Daxxn/MicLightV2_PCB/Docs/Renders/MicLightV2_Editable.png

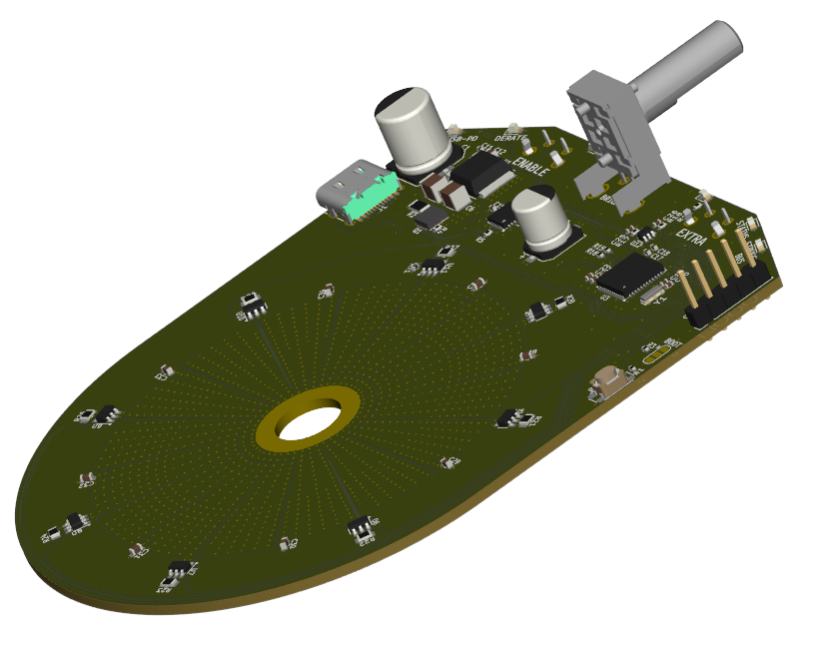
Docs/Renders/MicLightV2_Editable.png
