Daxxn/MicLightV2_PCB/Docs/BOMs/MicLightV2_REV3_BOM.csv

Reference | Value | PartNumber | Datasheet | Description | Color
C1 | 100u | 0201-0200-00001 | ${DATASHEETS}/UWT.pdf | CAP ALUM 100uF 50V 140mA@120Hz ±20% SMD,D8xL10mm Aluminum Electrolytic Capacitors - SMD ROHS
C2 | 10u | 0201-0100-00040 | ${DATASHEETS}/CL32A106KAULNNE.pdf | CAP CER 10UF 25V X5R 1210
C3 | 10u | 0201-0100-00040 | ${DATASHEETS}/CL32A106KAULNNE.pdf | CAP CER 10UF 25V X5R 1210
C4 | 10u | 0201-0100-00040 | ${DATASHEETS}/CL32A106KAULNNE.pdf | CAP CER 10UF 25V X5R 1210
C5 | 1u | 0201-0100-00051 | ${DATASHEETS}/CL10A105KA8NNNC.pdf | CAP CER 1UF 25V X5R 0603
C6 | 10u | 0201-0300-00008 | ${DATASHEETS}/TCJ.pdf | 10 µF Molded Tantalum Polymer Capacitor 35 V 1210 (3528 Metric) 200mOhm @ 100kHz
C7 | 10u | 0201-0300-00008 | ${DATASHEETS}/TCJ.pdf | 10 µF Molded Tantalum Polymer Capacitor 35 V 1210 (3528 Metric) 200mOhm @ 100kHz
C8 | 100u | 0201-0200-00018 | ~ | CAP ALUM 100uF 25V 6.3x7.7 Hilitchi Kit
C9 | 1u | 0201-0100-00051 | ${DATASHEETS}/CL10A105KA8NNNC.pdf | CAP CER 1UF 25V X5R 0603
C10 | 330n |  | ~ | Unpolarized Capacitor
C11 | 330n |  | ~ | Unpolarized Capacitor
C12 | 1u | 0201-0100-00051 | ${DATASHEETS}/CL10A105KA8NNNC.pdf | CAP CER 1UF 25V X5R 0603
C13 | 100n | 0201-0100-00001 | ${DATASHEETS}/GRM155R71H104KE14J.pdf | CAP CER 100nF 0.1UF 50V X7R 0402
C14 | 100n |  | ~ | Unpolarized Capacitor
C15 | 100n | 0201-0100-00001 | ${DATASHEETS}/GRM155R71H104KE14J.pdf | CAP CER 100nF 0.1UF 50V X7R 0402
C16 | 100n | 0201-0100-00001 | ${DATASHEETS}/GRM155R71H104KE14J.pdf | CAP CER 100nF 0.1UF 50V X7R 0402
C17 | 100n | 0201-0100-00001 | ${DATASHEETS}/GRM155R71H104KE14J.pdf | CAP CER 100nF 0.1UF 50V X7R 0402
C18 | 100n | 0201-0100-00001 | ${DATASHEETS}/GRM155R71H104KE14J.pdf | CAP CER 100nF 0.1UF 50V X7R 0402
C19 | 100n | 0201-0100-00001 | ${DATASHEETS}/GRM155R71H104KE14J.pdf | CAP CER 100nF 0.1UF 50V X7R 0402
C20 | 100n | 0201-0100-00001 | ${DATASHEETS}/GRM155R71H104KE14J.pdf | CAP CER 100nF 0.1UF 50V X7R 0402
C21 | 100n | 0201-0100-00001 | ${DATASHEETS}/GRM155R71H104KE14J.pdf | CAP CER 100nF 0.1UF 50V X7R 0402
C22 | 100n | 0201-0100-00001 | ${DATASHEETS}/GRM155R71H104KE14J.pdf | CAP CER 100nF 0.1UF 50V X7R 0402
C23 | 100n | 0201-0100-00001 | ${DATASHEETS}/GRM155R71H104KE14J.pdf | CAP CER 100nF 0.1UF 50V X7R 0402
C24 | 100n | 0201-0100-00001 | ${DATASHEETS}/GRM155R71H104KE14J.pdf | CAP CER 100nF 0.1UF 50V X7R 0402
C25 | 100n | 0201-0100-00001 | ${DATASHEETS}/GRM155R71H104KE14J.pdf | CAP CER 100nF 0.1UF 50V X7R 0402
C26 | 100n | 0201-0100-00001 | ${DATASHEETS}/GRM155R71H104KE14J.pdf | CAP CER 100nF 0.1UF 50V X7R 0402
C27 | 1u | 0201-0100-00051 | ${DATASHEETS}/CL10A105KA8NNNC.pdf | CAP CER 1UF 25V X5R 0603
C28 | 1u | 0201-0100-00051 | ${DATASHEETS}/CL10A105KA8NNNC.pdf | CAP CER 1UF 25V X5R 0603
C29 | 1u | 0201-0100-00051 | ${DATASHEETS}/CL10A105KA8NNNC.pdf | CAP CER 1UF 25V X5R 0603
C30 | 1u | 0201-0100-00051 | ${DATASHEETS}/CL10A105KA8NNNC.pdf | CAP CER 1UF 25V X5R 0603
C31 | 1u | 0201-0100-00051 | ${DATASHEETS}/CL10A105KA8NNNC.pdf | CAP CER 1UF 25V X5R 0603
C32 | 1u | 0201-0100-00051 | ${DATASHEETS}/CL10A105KA8NNNC.pdf | CAP CER 1UF 25V X5R 0603
C33 | 1u | 0201-0100-00051 | ${DATASHEETS}/CL10A105KA8NNNC.pdf | CAP CER 1UF 25V X5R 0603
C34 | 1u | 0201-0100-00051 | ${DATASHEETS}/CL10A105KA8NNNC.pdf | CAP CER 1UF 25V X5R 0603
C35 | 100n | 0201-0100-00001 | ${DATASHEETS}/GRM155R71H104KE14J.pdf | CAP CER 100nF 0.1UF 50V X7R 0402
C36 | 100n | 0201-0100-00001 | ${DATASHEETS}/GRM155R71H104KE14J.pdf | CAP CER 100nF 0.1UF 50V X7R 0402
C37 | 100n | 0201-0100-00001 | ${DATASHEETS}/GRM155R71H104KE14J.pdf | CAP CER 100nF 0.1UF 50V X7R 0402
C38 | 100n | 0201-0100-00001 | ${DATASHEETS}/GRM155R71H104KE14J.pdf | CAP CER 100nF 0.1UF 50V X7R 0402
C39 | 100n | 0201-0100-00001 | ${DATASHEETS}/GRM155R71H104KE14J.pdf | CAP CER 100nF 0.1UF 50V X7R 0402
C40 | 100n | 0201-0100-00001 | ${DATASHEETS}/GRM155R71H104KE14J.pdf | CAP CER 100nF 0.1UF 50V X7R 0402
C41 | 100n | 0201-0100-00001 | ${DATASHEETS}/GRM155R71H104KE14J.pdf | CAP CER 100nF 0.1UF 50V X7R 0402
C42 | 100n | 0201-0100-00001 | ${DATASHEETS}/GRM155R71H104KE14J.pdf | CAP CER 100nF 0.1UF 50V X7R 0402
C43 | 100n | 0201-0100-00001 | ${DATASHEETS}/GRM155R71H104KE14J.pdf | CAP CER 100nF 0.1UF 50V X7R 0402
C44 | 100n | 0201-0100-00001 | ${DATASHEETS}/GRM155R71H104KE14J.pdf | CAP CER 100nF 0.1UF 50V X7R 0402
C45 | 22u | 0201-0100-00067 | ${DATASHEETS}/C3216X5R1V226M160AC.pdf | CAP CER 22UF 35V X5R 1206
C46 | 22u | 0201-0100-00067 | ${DATASHEETS}/C3216X5R1V226M160AC.pdf | CAP CER 22UF 35V X5R 1206
C47 | 22u | 0201-0100-00067 | ${DATASHEETS}/C3216X5R1V226M160AC.pdf | CAP CER 22UF 35V X5R 1206
C48 | 22u | 0201-0100-00067 | ${DATASHEETS}/C3216X5R1V226M160AC.pdf | CAP CER 22UF 35V X5R 1206
C49 | 4u7 | 0201-0100-00074 | ${DATASHEETS}/CL21A475KLCLQNC.pdf | CAP CER 4.7UF 35V X5R 0805
C50 | 1u | 0201-0100-00050 | ${DATASHEETS}/CL05A105KO5NNNC.pdf | CAP CER 1UF 16V X5R 0402
C51 | 100n | 0201-0100-00001 | ${DATASHEETS}/GRM155R71H104KE14J.pdf | CAP CER 100nF 0.1UF 50V X7R 0402
C54 | 1u | 0201-0100-00050 | ${DATASHEETS}/CL05A105KO5NNNC.pdf | CAP CER 1UF 16V X5R 0402
C55 | 100n | 0201-0100-00001 | ${DATASHEETS}/GRM155R71H104KE14J.pdf | CAP CER 100nF 0.1UF 50V X7R 0402
D1 | IN-S63AS5UW | 0902-0000-00002 | ${DATASHEETS}/SM1204UAC.pdf | Amber 605nm LED Indication - Discrete 2.1V 1204 (3210 Metric) | AMBER
D3 | LTST-S321TBKT | 0902-0000-00004 | ${DATASHEETS}/LTST-S321TBKT.pdf | Blue 470nm LED Indication - Discrete 3.3V 2-SMD, No Lead | BLUE
D4 | IN-S63AS5UW | 0902-0000-00002 | ${DATASHEETS}/SM1204UAC.pdf | Amber 605nm LED Indication - Discrete 2.1V 1204 (3210 Metric) | AMBER
D5 | SM1204SGC | 0902-0000-00005 | ${DATASHEETS}/SM1204UAC.pdf | Green 574nm LED Indication - Discrete 2.1V 1204 (3210 Metric) | GREEN
D6 | JK3030AWT-P-H40EA0000-N0000001 | 0900-0000-00021 | ${DATASHEETS}/JSeries-3030.pdf | LED J NEUTRAL WHT 4000K SMD | WHITE
D7 | JK3030AWT-P-H40EA0000-N0000001 | 0900-0000-00021 | ${DATASHEETS}/JSeries-3030.pdf | LED J NEUTRAL WHT 4000K SMD | WHITE
D8 | JK3030AWT-P-H40EA0000-N0000001 | 0900-0000-00021 | ${DATASHEETS}/JSeries-3030.pdf | LED J NEUTRAL WHT 4000K SMD | WHITE
D9 | JK3030AWT-P-H40EA0000-N0000001 | 0900-0000-00021 | ${DATASHEETS}/JSeries-3030.pdf | LED J NEUTRAL WHT 4000K SMD | WHITE
D10 | JK3030AWT-P-H40EA0000-N0000001 | 0900-0000-00021 | ${DATASHEETS}/JSeries-3030.pdf | LED J NEUTRAL WHT 4000K SMD | WHITE
D11 | JK3030AWT-P-H40EA0000-N0000001 | 0900-0000-00021 | ${DATASHEETS}/JSeries-3030.pdf | LED J NEUTRAL WHT 4000K SMD | WHITE
D12 | JK3030AWT-P-H40EA0000-N0000001 | 0900-0000-00021 | ${DATASHEETS}/JSeries-3030.pdf | LED J NEUTRAL WHT 4000K SMD | WHITE
D13 | JK3030AWT-P-H40EA0000-N0000001 | 0900-0000-00021 | ${DATASHEETS}/JSeries-3030.pdf | LED J NEUTRAL WHT 4000K SMD | WHITE
D14 | JK3030AWT-P-H40EA0000-N0000001 | 0900-0000-00021 | ${DATASHEETS}/JSeries-3030.pdf | LED J NEUTRAL WHT 4000K SMD | WHITE
D15 | JK3030AWT-P-H40EA0000-N0000001 | 0900-0000-00021 | ${DATASHEETS}/JSeries-3030.pdf | LED J NEUTRAL WHT 4000K SMD | WHITE
D16 | JK3030AWT-P-H40EA0000-N0000001 | 0900-0000-00021 | ${DATASHEETS}/JSeries-3030.pdf | LED J NEUTRAL WHT 4000K SMD | WHITE
D17 | JK3030AWT-P-H40EA0000-N0000001 | 0900-0000-00021 | ${DATASHEETS}/JSeries-3030.pdf | LED J NEUTRAL WHT 4000K SMD | WHITE
D18 | JK3030AWT-P-H40EA0000-N0000001 | 0900-0000-00021 | ${DATASHEETS}/JSeries-3030.pdf | LED J NEUTRAL WHT 4000K SMD | WHITE
D19 | JK3030AWT-P-H40EA0000-N0000001 | 0900-0000-00021 | ${DATASHEETS}/JSeries-3030.pdf | LED J NEUTRAL WHT 4000K SMD | WHITE
D20 | JK3030AWT-P-H40EA0000-N0000001 | 0900-0000-00021 | ${DATASHEETS}/JSeries-3030.pdf | LED J NEUTRAL WHT 4000K SMD | WHITE
D21 | JK3030AWT-P-H40EA0000-N0000001 | 0900-0000-00021 | ${DATASHEETS}/JSeries-3030.pdf | LED J NEUTRAL WHT 4000K SMD | WHITE
D23 | RB751V-40-AU_R1_000A1 | 0501-0000-00004 | ${DATASHEETS}/RB751V-40-AU.pdf | Diode Schottky 40 V 300mA Surface Mount SOD-323
D24 | LTST-S321TBKT | 0902-0000-00004 | ${DATASHEETS}/LTST-S321TBKT.pdf | Blue 470nm LED Indication - Discrete 3.3V 2-SMD, No Lead | BLUE
J1 | 12402012E212A | 0318-0000-00020 | ${DATASHEETS}/12402012E212A,pdf | USB-C (USB TYPE-C) USB 2.0 Receptacle Connector 24 (16+8 Dummy) Position Surface Mount, Right Angle; Through Hole
JPR1 | SWD-HDR-5 |  | ~ | SWD Header 5Pin Wo/ SWO
Q1 | STL11N3LLH6 | 1806-0000-00022 | ${DATASHEETS}/STL11N3LLH6.pdf | N-Channel 30 V 11A (Tc) 2W (Ta), 50W (Tc) Surface Mount PowerFlat (3.3x3.3)
Q2 | MJD112T4 | 1802-0000-00002 | ${DATASHEETS}/MJD112T4.pdf | TRANS NPN DARL 100V 2A DPAK
Q3 | MJD112T4 | 1802-0000-00002 | ${DATASHEETS}/MJD112T4.pdf | TRANS NPN DARL 100V 2A DPAK
Q4 | MJD112T4 | 1802-0000-00002 | ${DATASHEETS}/MJD112T4.pdf | TRANS NPN DARL 100V 2A DPAK
Q5 | MJD112T4 | 1802-0000-00002 | ${DATASHEETS}/MJD112T4.pdf | TRANS NPN DARL 100V 2A DPAK
Q6 | MJD112T4 | 1802-0000-00002 | ${DATASHEETS}/MJD112T4.pdf | TRANS NPN DARL 100V 2A DPAK
Q7 | MJD112T4 | 1802-0000-00002 | ${DATASHEETS}/MJD112T4.pdf | TRANS NPN DARL 100V 2A DPAK
Q8 | MJD112T4 | 1802-0000-00002 | ${DATASHEETS}/MJD112T4.pdf | TRANS NPN DARL 100V 2A DPAK
Q9 | MJD112T4 | 1802-0000-00002 | ${DATASHEETS}/MJD112T4.pdf | TRANS NPN DARL 100V 2A DPAK
R1 | 10K | 0204-0000-00016 | ${DATASHEETS}/RC-Series.pdf | RES 10K OHM 5% 1/16W 0402
R2 | 10m | 0204-0200-00005 | ${DATASHEETS}/CSRN.pdf | 10 mOhms ±1% 0.5W, 1/2W Chip Resistor 1206 (3216 Metric) Current Sense Thick Film
R3 | 10K | 0204-0000-00016 | ${DATASHEETS}/RC-Series.pdf | RES 10K OHM 5% 1/16W 0402
R4 | 10K | 0204-0000-00016 | ${DATASHEETS}/RC-Series.pdf | RES 10K OHM 5% 1/16W 0402
R5 | 100 | 0204-0000-00011 | ${DATASHEETS}/RC-Series.pdf | RES 100 OHM 5% 1/16W 0402
R6 | 5K1 | 0204-0000-00115 | ${DATASHEETS}/RC-Series.pdf | RES 5.1K OHM 1% 1/16W 0402
R7 | 5K1 | 0204-0000-00115 | ${DATASHEETS}/RC-Series.pdf | RES 5.1K OHM 1% 1/16W 0402
R8 | 2K7 | 0204-0000-00121 | ${DATASHEETS}/CRGCQ_SERIES.pdf | RES 2.7K OHM 1% 1/16W 0402
R9 | 10K | 0204-0000-00016 | ${DATASHEETS}/RC-Series.pdf | RES 10K OHM 5% 1/16W 0402
R10 | 1K | 0204-0000-00032 | ${DATASHEETS}/RC-Series.pdf | RES 1K OHM 5% 1/16W 0402
R11 | 1K | 0204-0000-00032 | ${DATASHEETS}/RC-Series.pdf | RES 1K OHM 5% 1/16W 0402
R13 | 1K | 0204-0000-00032 | ${DATASHEETS}/RC-Series.pdf | RES 1K OHM 5% 1/16W 0402
R17 | 100K | 0204-0000-00013 | ${DATASHEETS}/SEI-RMCF_RMCP.pdf | RES 100K OHM 1% 1/16W 0402
R18 | 100K | 0204-0000-00013 | ${DATASHEETS}/SEI-RMCF_RMCP.pdf | RES 100K OHM 1% 1/16W 0402
R19 | PTV09A-2030F-A103 | 0404-0000-00035 | ${DATASHEETS}/PTV09.pdf | POT 10K OHM 1/20W CARBON LOG
R20 | 100 |  | ~ | Resistor
R21 | 1K 0.1% | 0204-0100-00012 | ${DATASHEETS}/RT-Series.pdf | 1 kOhms ±0.1% 0.063W, 1/16W Chip Resistor 0402 (1005 Metric) Thin Film
R22 | 10K 0.1% | 0204-0100-00019 | ${DATASHEETS}/TNPW_E3.pdf | 10 kOhms ±0.1% 0.13W Chip Resistor 0402 (1005 Metric) Anti-Sulfur, Automotive AEC-Q200, Moisture Resistant Thin Film
R23 | 10K | 0204-0000-00016 | ${DATASHEETS}/RC-Series.pdf | RES 10K OHM 5% 1/16W 0402
R24 | 10 | 0204-0200-00031 | ${DATASHEETS}/CRCW-HPE3.pdf | 10 Ohms ±1% 1.5W Chip Resistor 1218 (3246 Metric) Automotive AEC-Q200, Pulse Withstanding Thick Film
R25 | 100 |  | ~ | Resistor
R26 | 1K 0.1% | 0204-0100-00012 | ${DATASHEETS}/RT-Series.pdf | 1 kOhms ±0.1% 0.063W, 1/16W Chip Resistor 0402 (1005 Metric) Thin Film
R27 | 10K 0.1% | 0204-0100-00019 | ${DATASHEETS}/TNPW_E3.pdf | 10 kOhms ±0.1% 0.13W Chip Resistor 0402 (1005 Metric) Anti-Sulfur, Automotive AEC-Q200, Moisture Resistant Thin Film
R28 | 1K | 0204-0000-00032 | ${DATASHEETS}/RC-Series.pdf | RES 1K OHM 5% 1/16W 0402
R29 | 100K | 0204-0000-00013 | ${DATASHEETS}/SEI-RMCF_RMCP.pdf | RES 100K OHM 1% 1/16W 0402
R30 | 10K | 0204-0000-00016 | ${DATASHEETS}/RC-Series.pdf | RES 10K OHM 5% 1/16W 0402
R31 | 10 | 0204-0200-00031 | ${DATASHEETS}/CRCW-HPE3.pdf | 10 Ohms ±1% 1.5W Chip Resistor 1218 (3246 Metric) Automotive AEC-Q200, Pulse Withstanding Thick Film
R32 | 100 |  | ~ | Resistor
R33 | 1K 0.1% | 0204-0100-00012 | ${DATASHEETS}/RT-Series.pdf | 1 kOhms ±0.1% 0.063W, 1/16W Chip Resistor 0402 (1005 Metric) Thin Film
R34 | 10K 0.1% | 0204-0100-00019 | ${DATASHEETS}/TNPW_E3.pdf | 10 kOhms ±0.1% 0.13W Chip Resistor 0402 (1005 Metric) Anti-Sulfur, Automotive AEC-Q200, Moisture Resistant Thin Film
R35 | 10K | 0204-0000-00016 | ${DATASHEETS}/RC-Series.pdf | RES 10K OHM 5% 1/16W 0402
R36 | 10 | 0204-0200-00031 | ${DATASHEETS}/CRCW-HPE3.pdf | 10 Ohms ±1% 1.5W Chip Resistor 1218 (3246 Metric) Automotive AEC-Q200, Pulse Withstanding Thick Film
R37 | 100 |  | ~ | Resistor
R38 | 1K 0.1% | 0204-0100-00012 | ${DATASHEETS}/RT-Series.pdf | 1 kOhms ±0.1% 0.063W, 1/16W Chip Resistor 0402 (1005 Metric) Thin Film
R39 | 10K 0.1% | 0204-0100-00019 | ${DATASHEETS}/TNPW_E3.pdf | 10 kOhms ±0.1% 0.13W Chip Resistor 0402 (1005 Metric) Anti-Sulfur, Automotive AEC-Q200, Moisture Resistant Thin Film
R40 | 10K | 0204-0000-00016 | ${DATASHEETS}/RC-Series.pdf | RES 10K OHM 5% 1/16W 0402
R41 | 10 | 0204-0200-00031 | ${DATASHEETS}/CRCW-HPE3.pdf | 10 Ohms ±1% 1.5W Chip Resistor 1218 (3246 Metric) Automotive AEC-Q200, Pulse Withstanding Thick Film
R42 | 100 |  | ~ | Resistor
R43 | 1K 0.1% | 0204-0100-00012 | ${DATASHEETS}/RT-Series.pdf | 1 kOhms ±0.1% 0.063W, 1/16W Chip Resistor 0402 (1005 Metric) Thin Film
R44 | 10K 0.1% | 0204-0100-00019 | ${DATASHEETS}/TNPW_E3.pdf | 10 kOhms ±0.1% 0.13W Chip Resistor 0402 (1005 Metric) Anti-Sulfur, Automotive AEC-Q200, Moisture Resistant Thin Film
R45 | 10K | 0204-0000-00016 | ${DATASHEETS}/RC-Series.pdf | RES 10K OHM 5% 1/16W 0402
R46 | 10 | 0204-0200-00031 | ${DATASHEETS}/CRCW-HPE3.pdf | 10 Ohms ±1% 1.5W Chip Resistor 1218 (3246 Metric) Automotive AEC-Q200, Pulse Withstanding Thick Film
R47 | 100 |  | ~ | Resistor
R48 | 1K 0.1% | 0204-0100-00012 | ${DATASHEETS}/RT-Series.pdf | 1 kOhms ±0.1% 0.063W, 1/16W Chip Resistor 0402 (1005 Metric) Thin Film
R49 | 10K 0.1% | 0204-0100-00019 | ${DATASHEETS}/TNPW_E3.pdf | 10 kOhms ±0.1% 0.13W Chip Resistor 0402 (1005 Metric) Anti-Sulfur, Automotive AEC-Q200, Moisture Resistant Thin Film
R50 | 10K | 0204-0000-00016 | ${DATASHEETS}/RC-Series.pdf | RES 10K OHM 5% 1/16W 0402
R51 | 10 | 0204-0200-00031 | ${DATASHEETS}/CRCW-HPE3.pdf | 10 Ohms ±1% 1.5W Chip Resistor 1218 (3246 Metric) Automotive AEC-Q200, Pulse Withstanding Thick Film
R52 | 100 |  | ~ | Resistor
R53 | 1K 0.1% | 0204-0100-00012 | ${DATASHEETS}/RT-Series.pdf | 1 kOhms ±0.1% 0.063W, 1/16W Chip Resistor 0402 (1005 Metric) Thin Film
R54 | 10K 0.1% | 0204-0100-00019 | ${DATASHEETS}/TNPW_E3.pdf | 10 kOhms ±0.1% 0.13W Chip Resistor 0402 (1005 Metric) Anti-Sulfur, Automotive AEC-Q200, Moisture Resistant Thin Film
R55 | 10K | 0204-0000-00016 | ${DATASHEETS}/RC-Series.pdf | RES 10K OHM 5% 1/16W 0402
R56 | 10 | 0204-0200-00031 | ${DATASHEETS}/CRCW-HPE3.pdf | 10 Ohms ±1% 1.5W Chip Resistor 1218 (3246 Metric) Automotive AEC-Q200, Pulse Withstanding Thick Film
R57 | 100 |  | ~ | Resistor
R58 | 1K 0.1% | 0204-0100-00012 | ${DATASHEETS}/RT-Series.pdf | 1 kOhms ±0.1% 0.063W, 1/16W Chip Resistor 0402 (1005 Metric) Thin Film
R59 | 10K 0.1% | 0204-0100-00019 | ${DATASHEETS}/TNPW_E3.pdf | 10 kOhms ±0.1% 0.13W Chip Resistor 0402 (1005 Metric) Anti-Sulfur, Automotive AEC-Q200, Moisture Resistant Thin Film
R60 | 10K | 0204-0000-00016 | ${DATASHEETS}/RC-Series.pdf | RES 10K OHM 5% 1/16W 0402
R61 | 10 | 0204-0200-00031 | ${DATASHEETS}/CRCW-HPE3.pdf | 10 Ohms ±1% 1.5W Chip Resistor 1218 (3246 Metric) Automotive AEC-Q200, Pulse Withstanding Thick Film
R62 | 100 | 0204-0000-00011 | ${DATASHEETS}/RC-Series.pdf | RES 100 OHM 5% 1/16W 0402
R63 | 100 | 0204-0000-00011 | ${DATASHEETS}/RC-Series.pdf | RES 100 OHM 5% 1/16W 0402
R64 | 100 | 0204-0000-00011 | ${DATASHEETS}/RC-Series.pdf | RES 100 OHM 5% 1/16W 0402
R65 | 100 | 0204-0000-00011 | ${DATASHEETS}/RC-Series.pdf | RES 100 OHM 5% 1/16W 0402
R66 | 100 | 0204-0000-00011 | ${DATASHEETS}/RC-Series.pdf | RES 100 OHM 5% 1/16W 0402
R67 | 100 | 0204-0000-00011 | ${DATASHEETS}/RC-Series.pdf | RES 100 OHM 5% 1/16W 0402
R68 | 100 | 0204-0000-00011 | ${DATASHEETS}/RC-Series.pdf | RES 100 OHM 5% 1/16W 0402
R69 | 100 | 0204-0000-00011 | ${DATASHEETS}/RC-Series.pdf | RES 100 OHM 5% 1/16W 0402
R70 | 10K | 0204-0000-00016 | ${DATASHEETS}/RC-Series.pdf | RES 10K OHM 5% 1/16W 0402
R71 | 226K | 0204-0000-00048 | ${DATASHEETS}/RC-Series.pdf | RES 226K OHM 1% 1/16W 0402
R72 | 43K2 | 0204-0000-00110 | ${DATASHEETS}/CR-Series.pdf | RES SMD 43.2K OHM 1% 1/16W 0402
R73 | 1K |  | ~ | Resistor
S1 | TL1105VF250Q | 0401-0000-00029 | ${DATASHEETS}/TL1105.pdf | SWITCH TACTILE SPST-NO 0.05A 12V
S2 | TL1105VF250Q | 0401-0000-00029 | ${DATASHEETS}/TL1105.pdf | SWITCH TACTILE SPST-NO 0.05A 12V
SW1 | TL3365AF180QG | 0401-0000-00007 | ${DATASHEETS}/TL3365.pdf | Tactile Switch SPST-NO Top Actuated Surface Mount
U1 | UA78M33CKVURG3 | 0811-0401-00020 | ${DATASHEETS}/UA78Mxx.pdf | Linear Voltage Regulator IC Positive Fixed 1 Output 500mA TO-252-3
U2 | STM32G0B1CCU6 | 0807-0200-00024 | ${DATASHEETS}\STM32G0B1CE.pdf | ARM Cortex-M0+ STM32G0 Microcontroller IC 32-Bit 64MHz 256KB (256K x 8) FLASH UFQFPN-48 (7x7)
U3 | TCPP01-M12 | 0811-0600-00013 | ${DATASHEETS}\TCPP01-M12.pdf | USB Type-C Overvoltage/Surge Protection IC Internal Switch 12-QFN (3x3)
U4 | APX321WG-7 | 0801-0400-00011 | ${DATASHEETS}/APX321.pdf | Low Voltage, Rail to Rail Opamp
U5 | APX321WG-7 | 0801-0400-00011 | ${DATASHEETS}/APX321.pdf | Low Voltage, Rail to Rail Opamp
U6 | APX321WG-7 | 0801-0400-00011 | ${DATASHEETS}/APX321.pdf | Low Voltage, Rail to Rail Opamp
U7 | APX321WG-7 | 0801-0400-00011 | ${DATASHEETS}/APX321.pdf | Low Voltage, Rail to Rail Opamp
U8 | APX321WG-7 | 0801-0400-00011 | ${DATASHEETS}/APX321.pdf | Low Voltage, Rail to Rail Opamp
U9 | APX321WG-7 | 0801-0400-00011 | ${DATASHEETS}/APX321.pdf | Low Voltage, Rail to Rail Opamp
U10 | APX321WG-7 | 0801-0400-00011 | ${DATASHEETS}/APX321.pdf | Low Voltage, Rail to Rail Opamp
U11 | APX321WG-7 | 0801-0400-00011 | ${DATASHEETS}/APX321.pdf | Low Voltage, Rail to Rail Opamp
U12 | TC7PZ17FU | 0806-0200-00010 | ${DATASHEETS}/TC7PZ17FU.pdf | Buffer, Non-Inverting 2 Element 1 Bit per Element Push-Pull Output SC-70-6
U13 | DAC8551IADGKR | 0802-0200-00003 | ${DATASHEETS}/DAC8551.pdf | 16 Bit Digital to Analog Converter 1 8-VSSOP
U14 | INA180A2IDBVT | 0801-0300-00005 | ${DATASHEETS}/INA180.pdf | Current Sense Amplifier 1 Circuit Rail-to-Rail SOT-23-5
U15 | DAC8551IADGKR | 0802-0200-00003 | ${DATASHEETS}/DAC8551.pdf | 16 Bit Digital to Analog Converter 1 8-VSSOP
Y1 | 16MHz | 1203-0000-00001 | ${DATASHEETS}/CSTNE16M0V53L000R0.pdf | 16 MHz Ceramic Resonator Built in Capacitor 15 pF ±0.2% 40 Ohms -40°C ~ 85°C Surface Mount
