Daxxn/MicLightV2_PCB/Docs/Schematics/MicLightV2_REV3.pdf

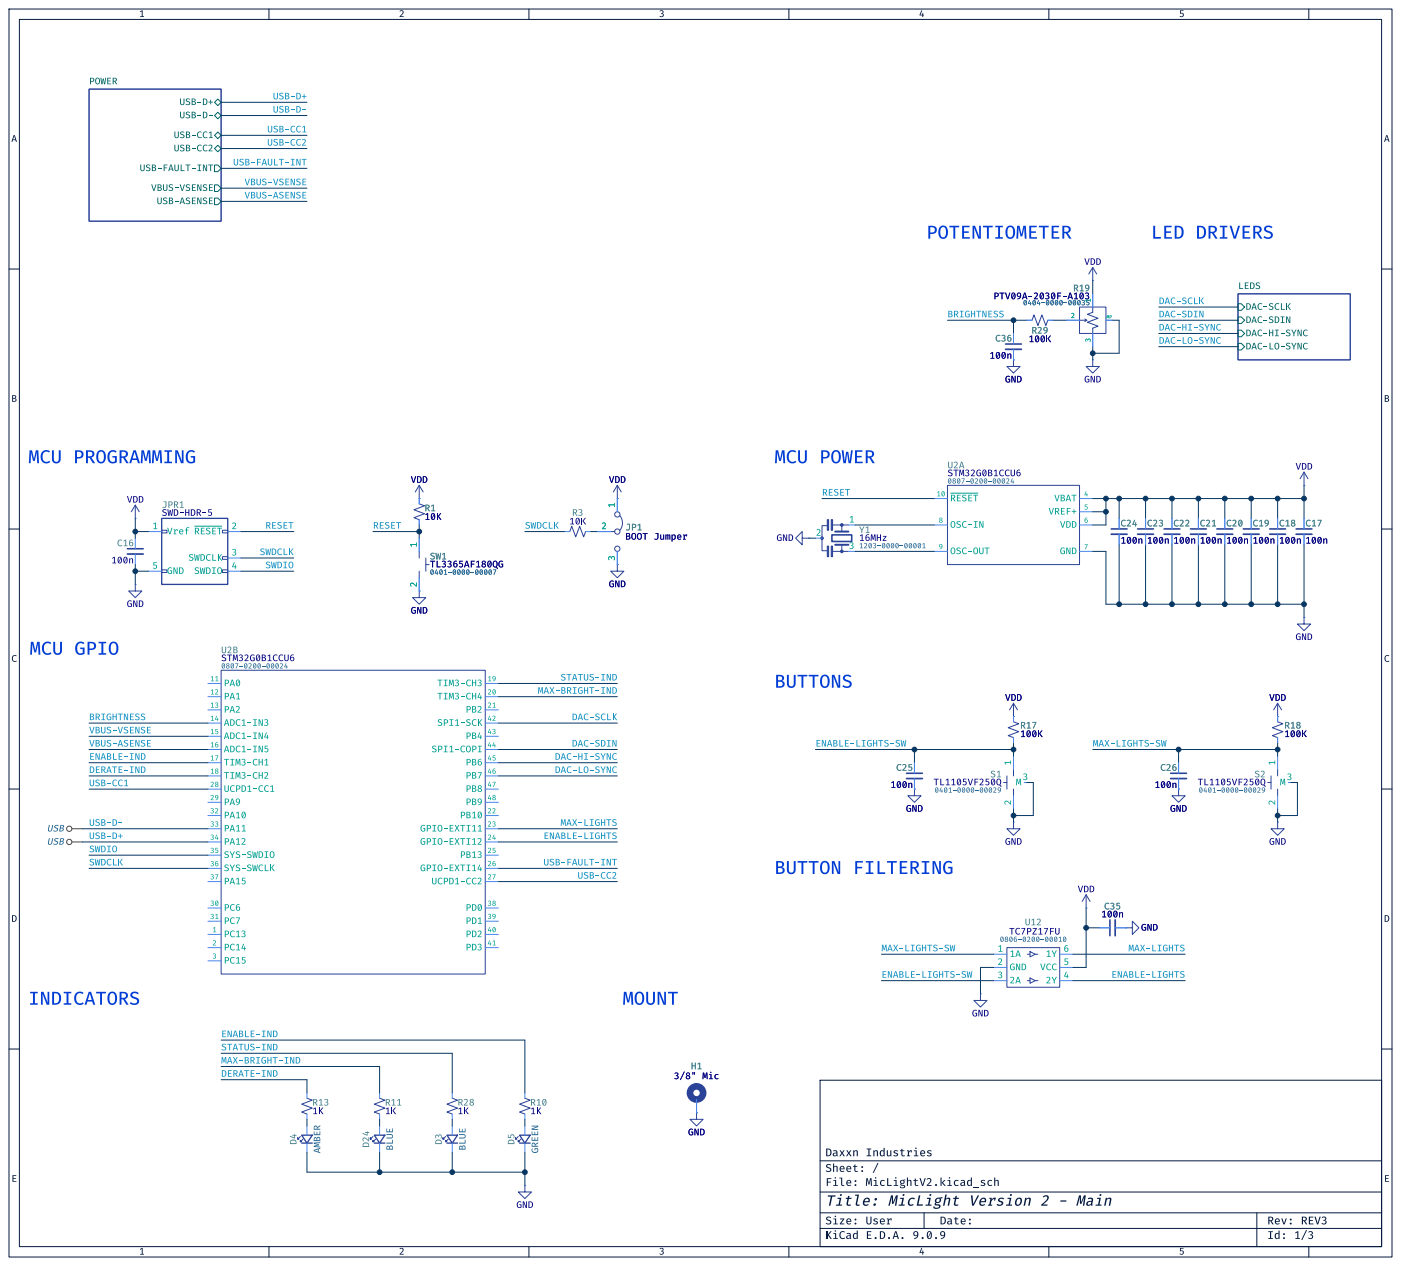
[picture p2: page 1]

LEDS USB-FAULT-INT VBUS-VSENSE USB-ASENSE USB-CC2 USB-CC1 USB-D+ USB-D- POWER

DAC-SCLK DAC-HI-SYNC
DAC-SDIN

STATUS-IND MAX-BRIGHT-IND

USB-CC1 VBUS-ASENSE USB-D- SWDCLK USB-D+ SWDIO
USB-CC2 ENABLE-IND
ENABLE-LIGHTS DERATE-IND

DAC-HI-SYNC
DAC-LO-SYNC MAX-LIGHTS

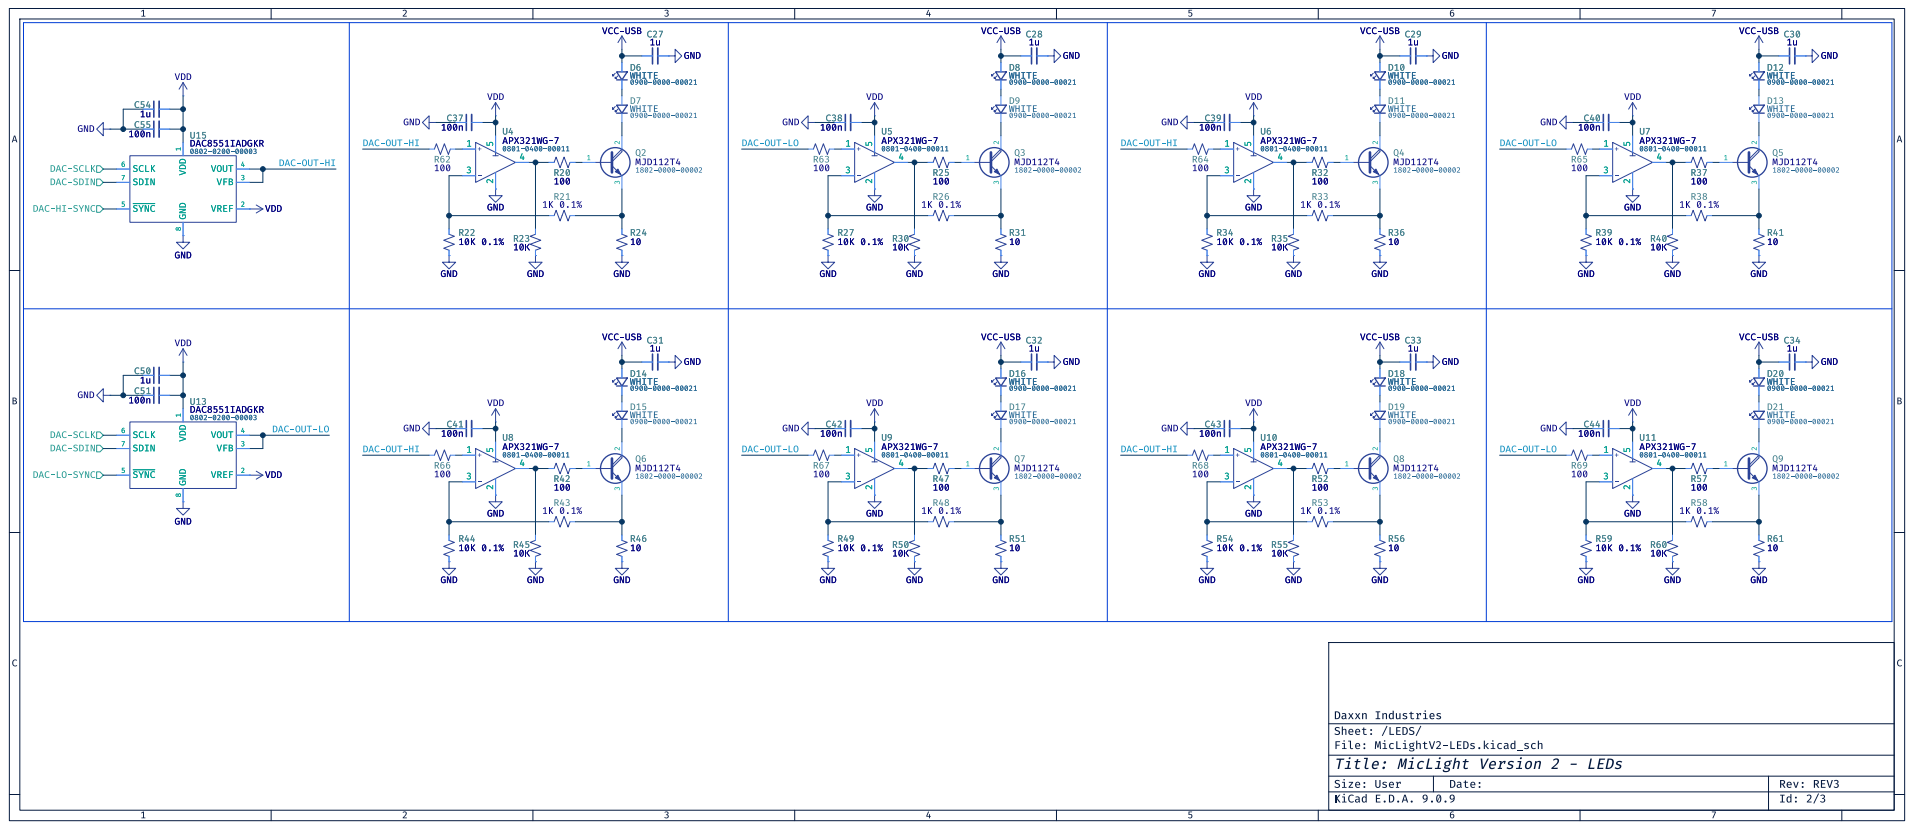
[picture p3: page 2]

1 GND
DAC-SCLK DAC-SDIN
DAC-SDIN

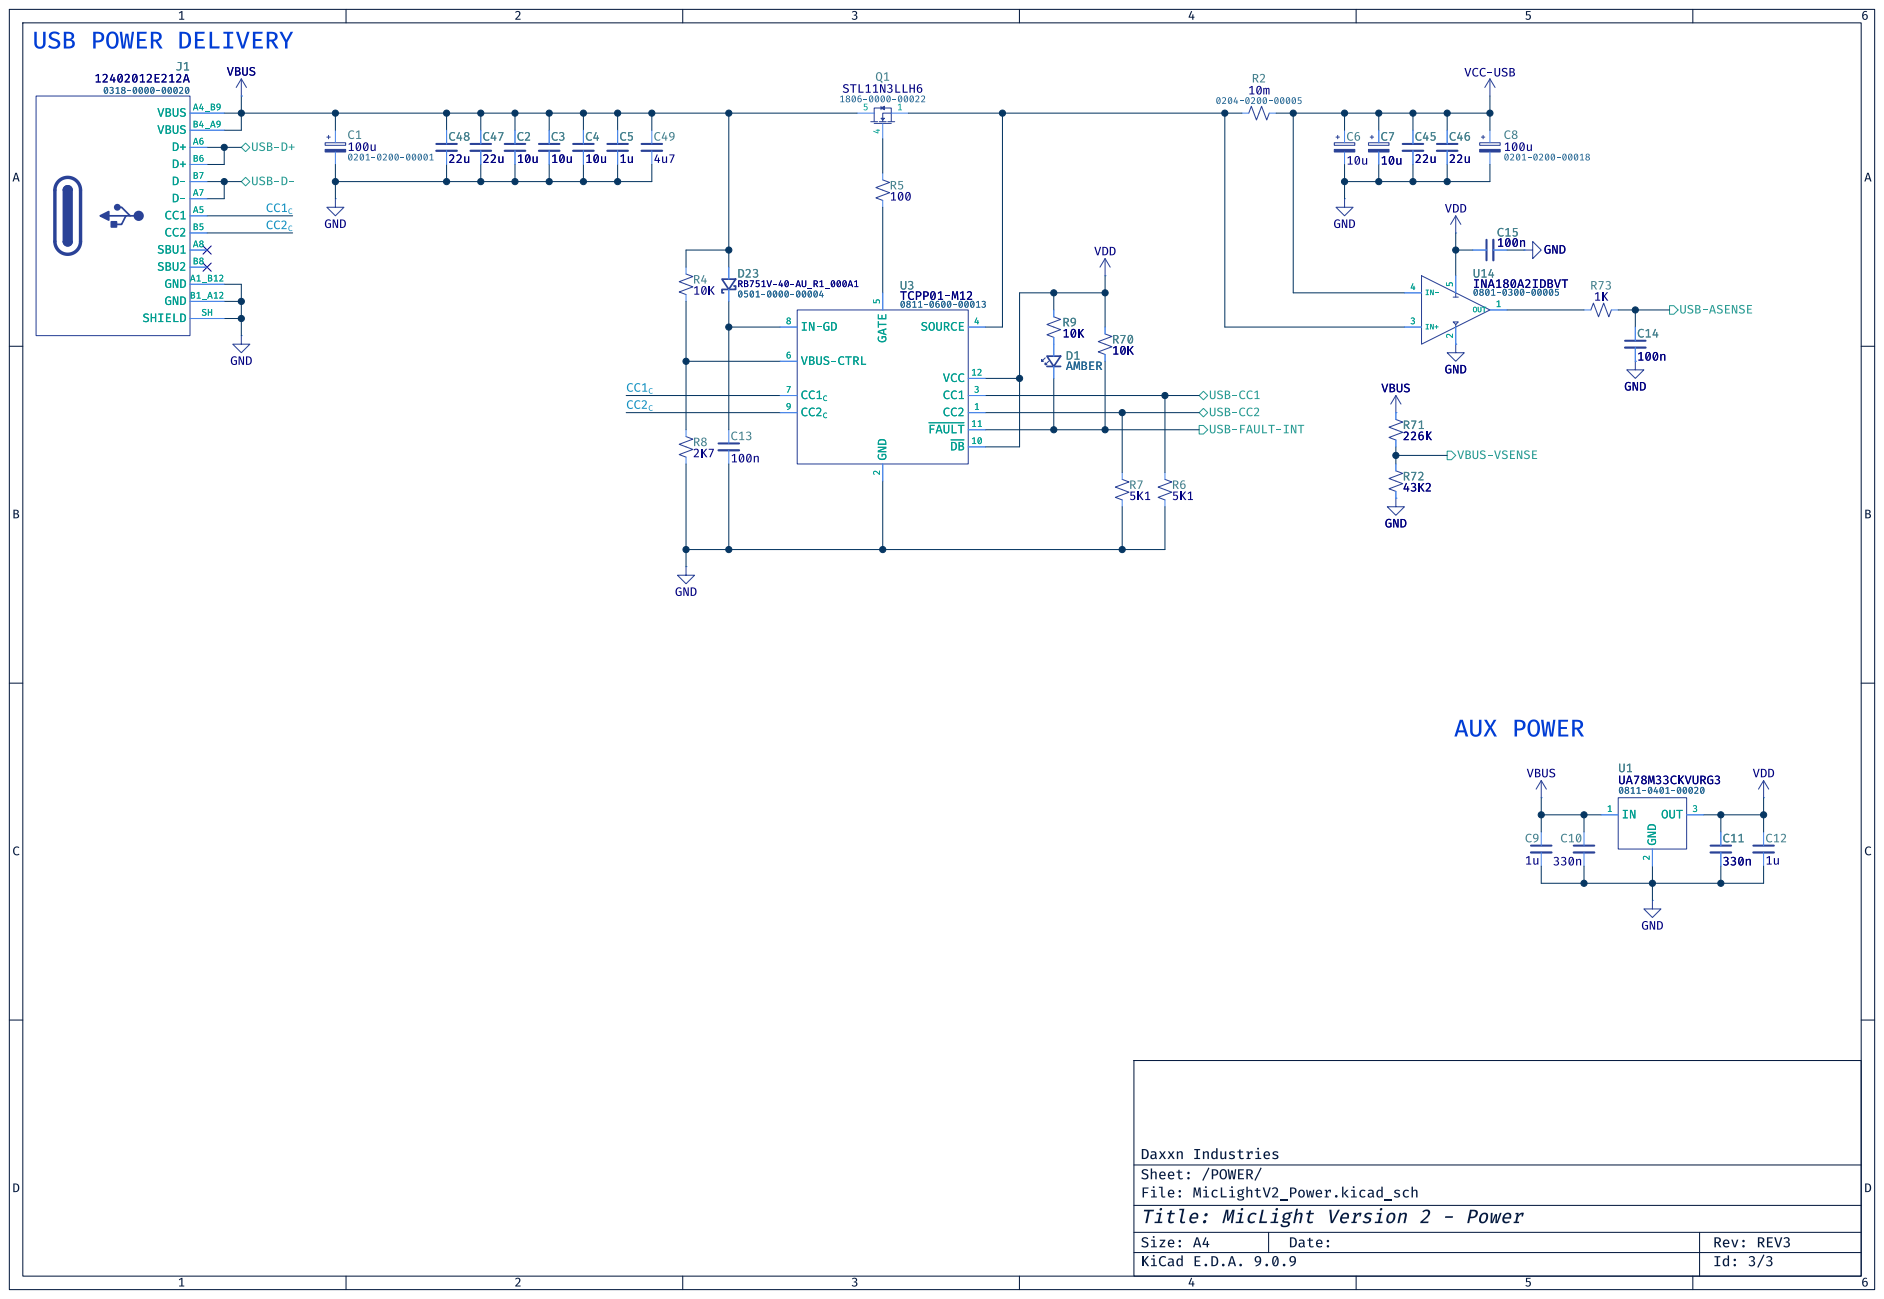
[picture p4: page 3]
