Daxxn/MicLightV2_PCB/Docs/Schematics/MicLightV2_REV2.pdf

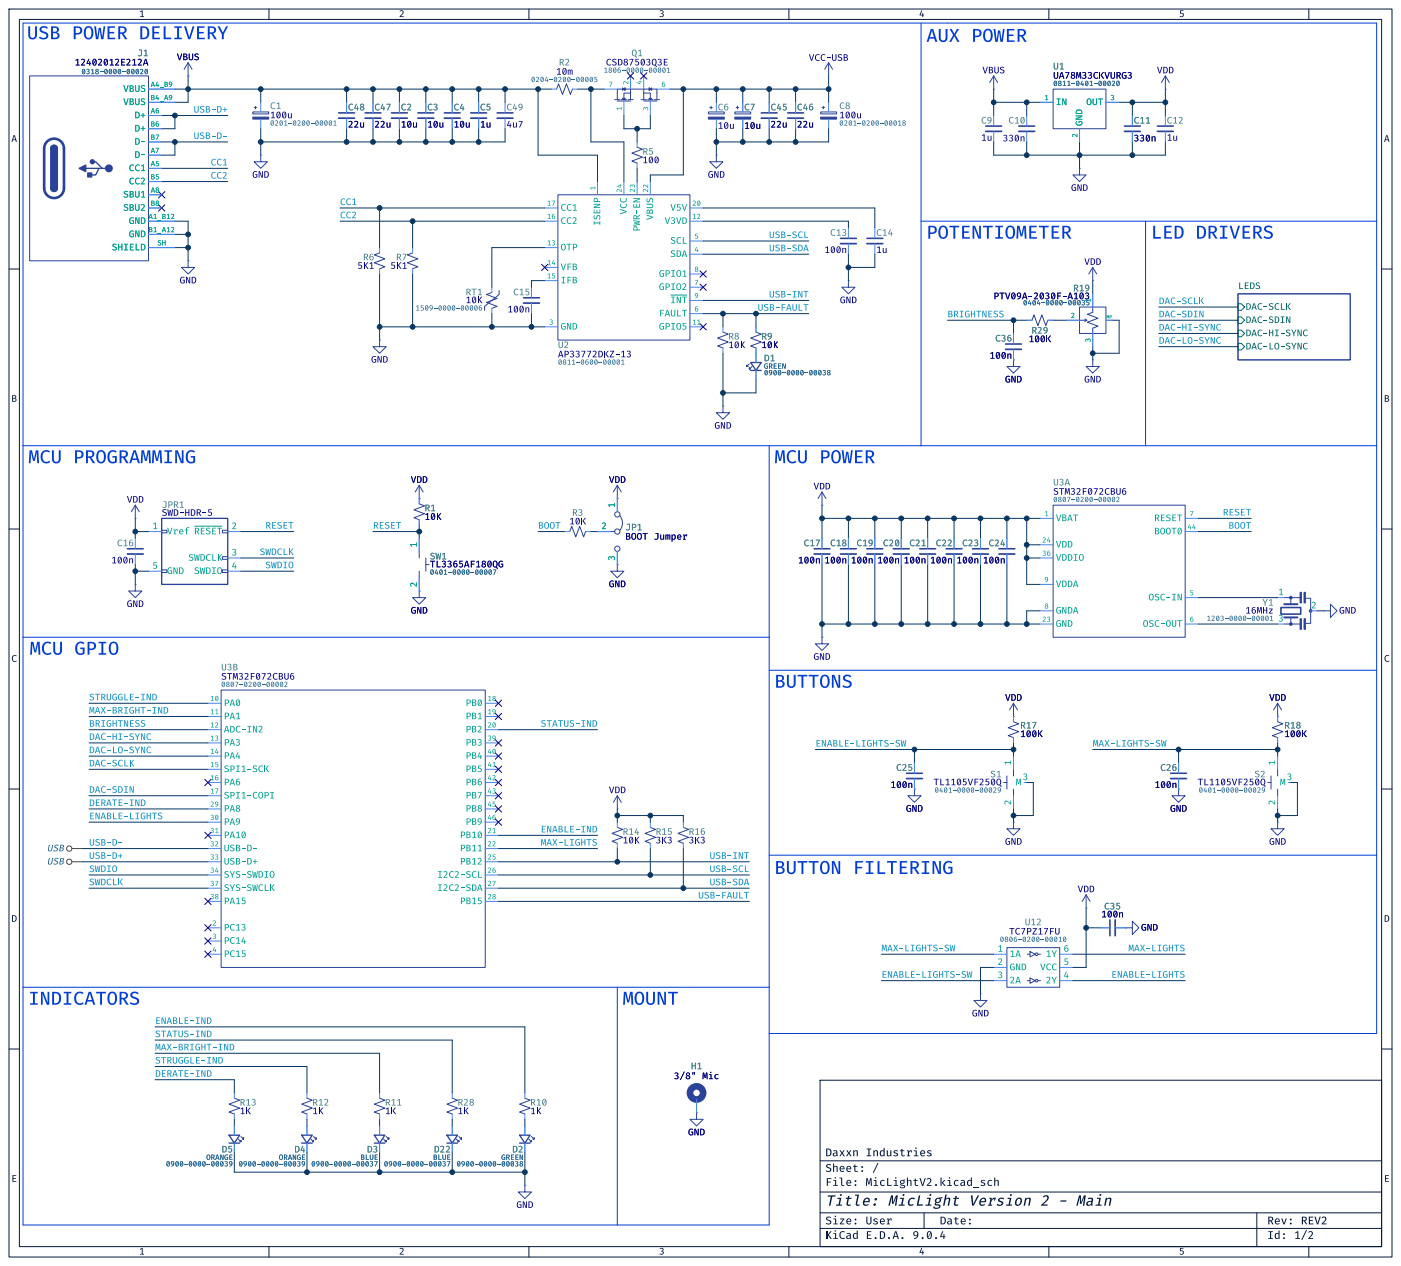
[picture p5: page 1]

USB-SCL USB-FAULT MOUNT

1 VCC 24 PWR-EN 23 VBUS 22 V5V

DAC-SCLK DAC-SDIN

DAC-SCLK DAC-HI-SYNC
DAC-SDIN

ENABLE-IND
STATUS-IND MAX-BRIGHT-IND

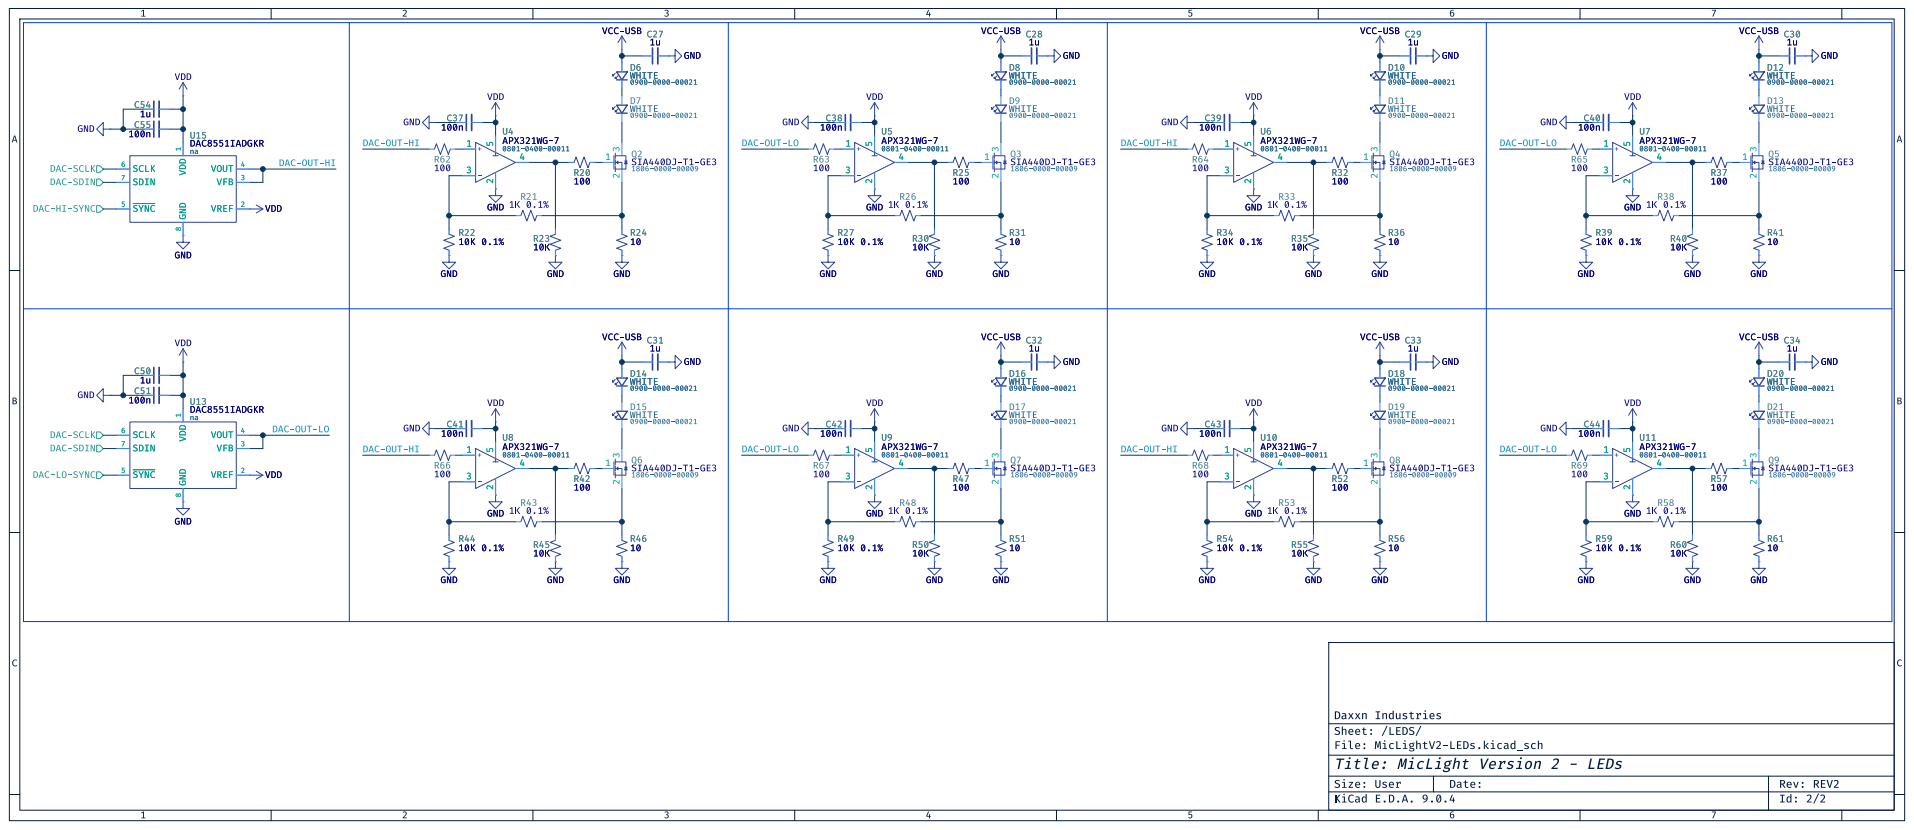
[picture p6: page 2]

DAC-SCLK DAC-SDIN

VCC-USB GND GND
