Daxxn/MicLightV2_PCB/Docs/Schematics/MicLightV2__Assembly_REV1.pdf

D14 | D12 | D¹¹ D13 D15 | D8 D6 D18 | D16 | D⁹ 1 | 2 | 3 | 4 | 5 | 6 1 | 2 | 3 | 4 | 5 | 6 ABCD | ABCD Date: KiCad E.D.A. 9.0.0 Size: A4 | Rev: 1
File: MicLightV2.kicad_pcb Sheet: Colored TOP Daxxn Industries Colored TOP - Page 1/2 D22 CZ1-0603-BLUE D22 NCR321UX U8 | C²¹ 100n | 3 R²²

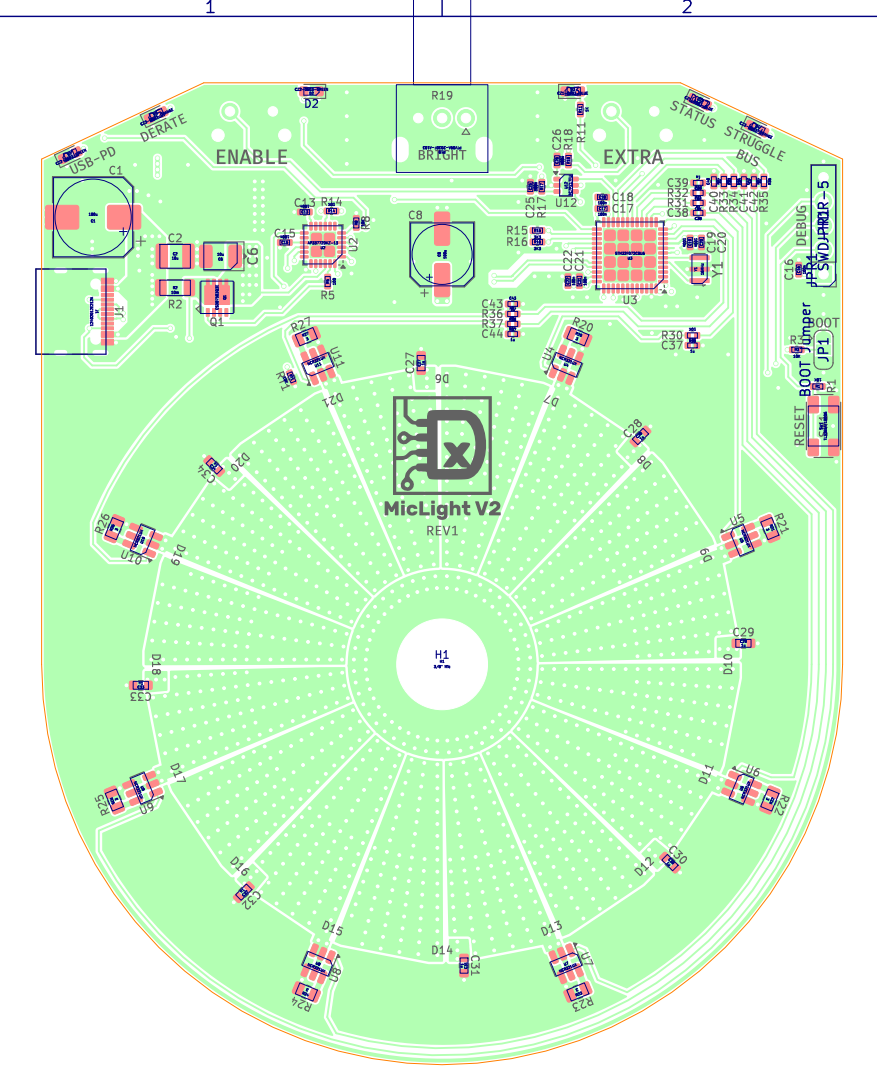
[picture p7: page 1]

Id: /1 Title: Mic Light Version 2

C46 R28 | C35 | C4 R29 | C47 S1C45 | C10 U1 | C11 C14 | C7 | C49 C⁹ C24 | R10 | C12 | R7 C48 R13 | R6 C36 | C5 C23 | R9 S2 | C3 R12 1 | 2 | 3 | 4 | 5 | 6 1 | 2 | 3 | 4 | 5 | 6 ABCD | ABCD Date: KiCad | E.D.A. 9.0.0 Size: A4 | Rev: 1
22u C45 | 330n C10 JK3030AWT-P-H40EA0000-N0000001 D7 | UA78M33CKVURG3 U1

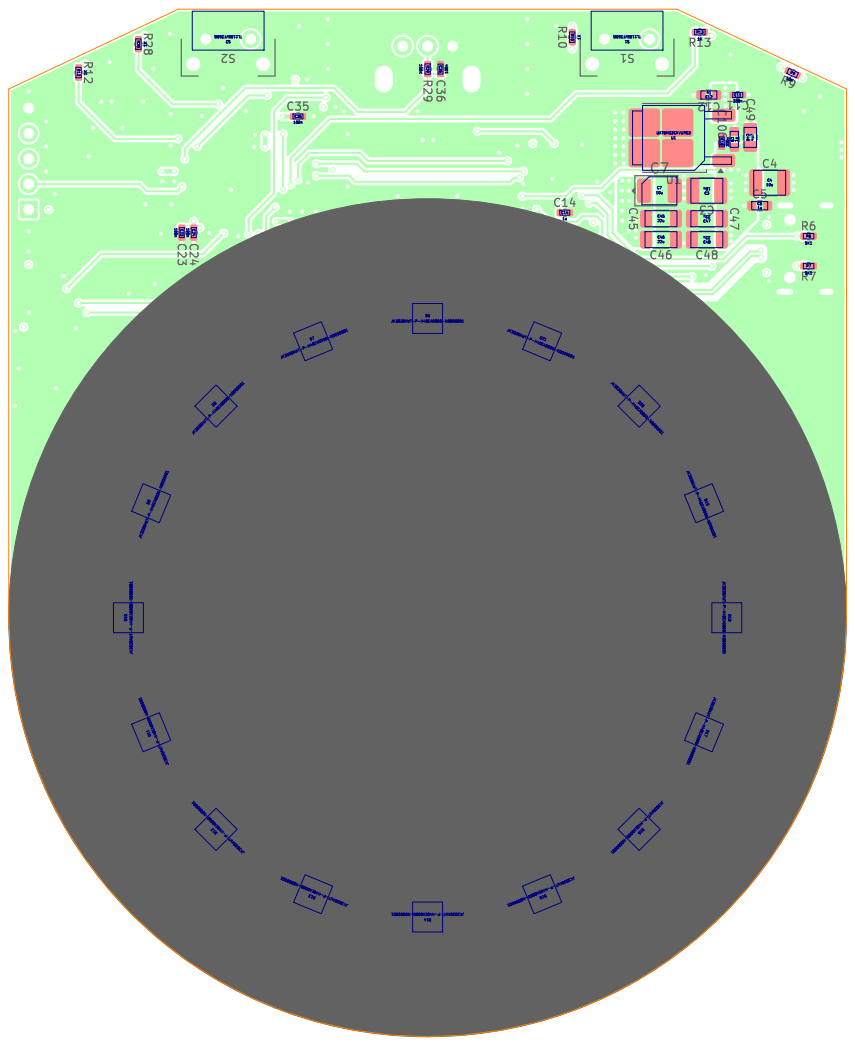
[picture p8: page 2]

Id: /1 Title: Mic Light Version 2
