Daxxn/MicLightV2_PCB/Docs/Schematics/MicLightV2_REV1.pdf

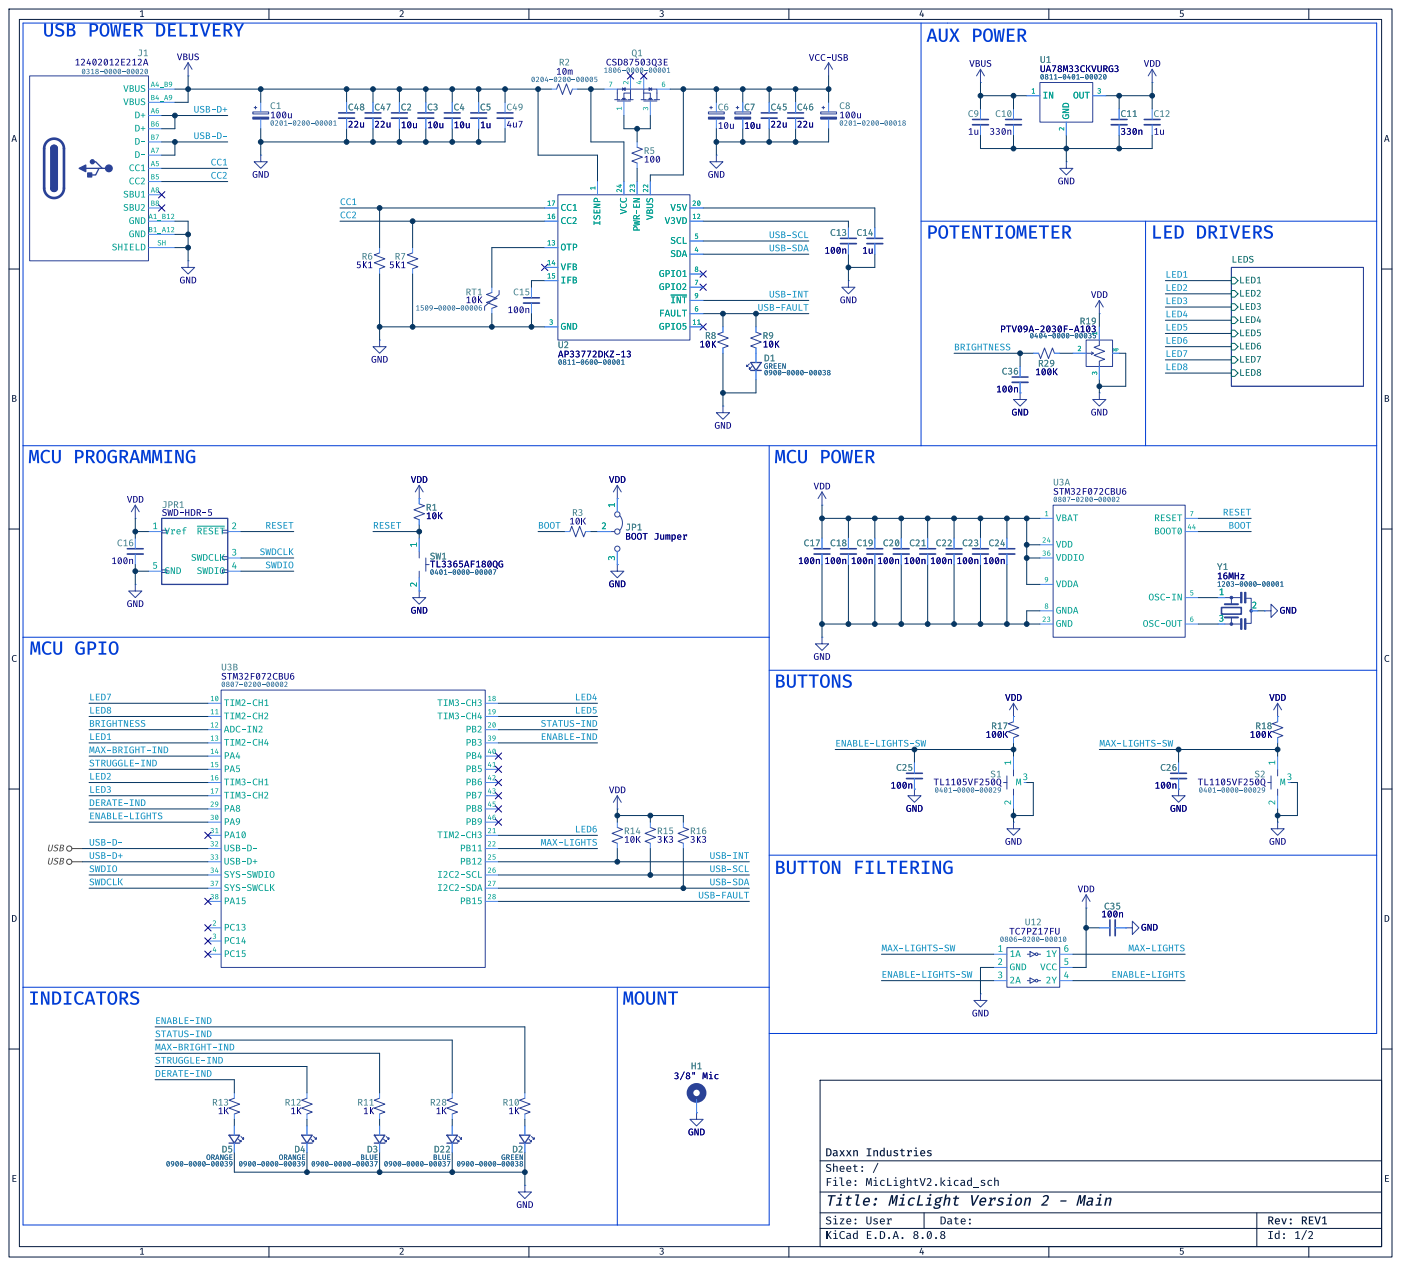
[picture p9: page 1]

20 VBUS 22 PWR-EN 23 VCC 24 GND
12 OTP

STATUS-IND MAX-LIGHTS
20 TIM2-CH3

USB-FAULT DERATE-IND

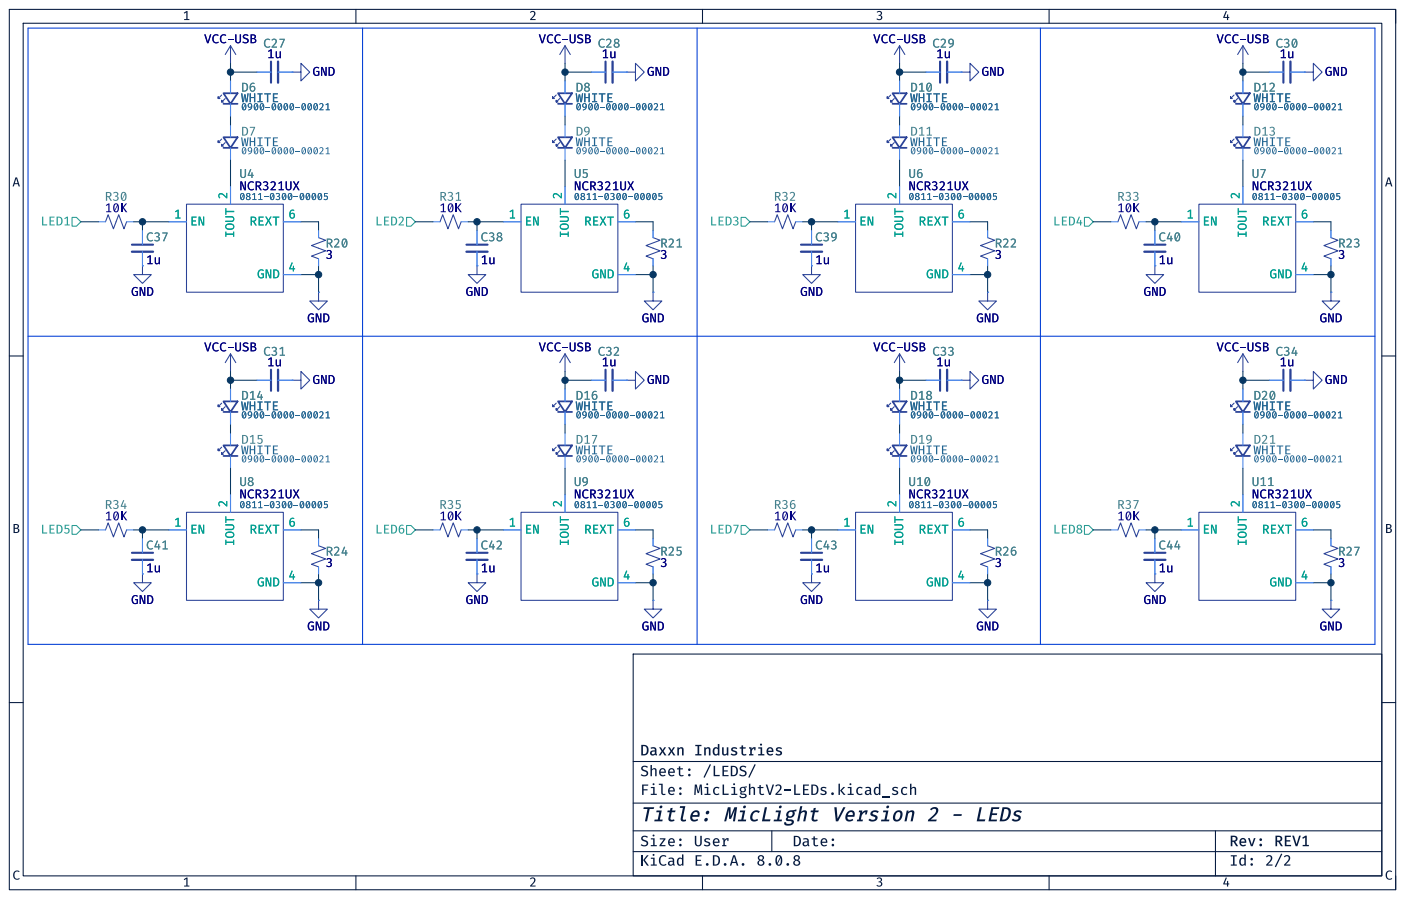
[picture p10: page 2]
