Daxxn/MicLightV2_PCB/MicLightV2.kicad_pcb

## KiCad design MicLightV2.kicad_pcb (2026-09-27)

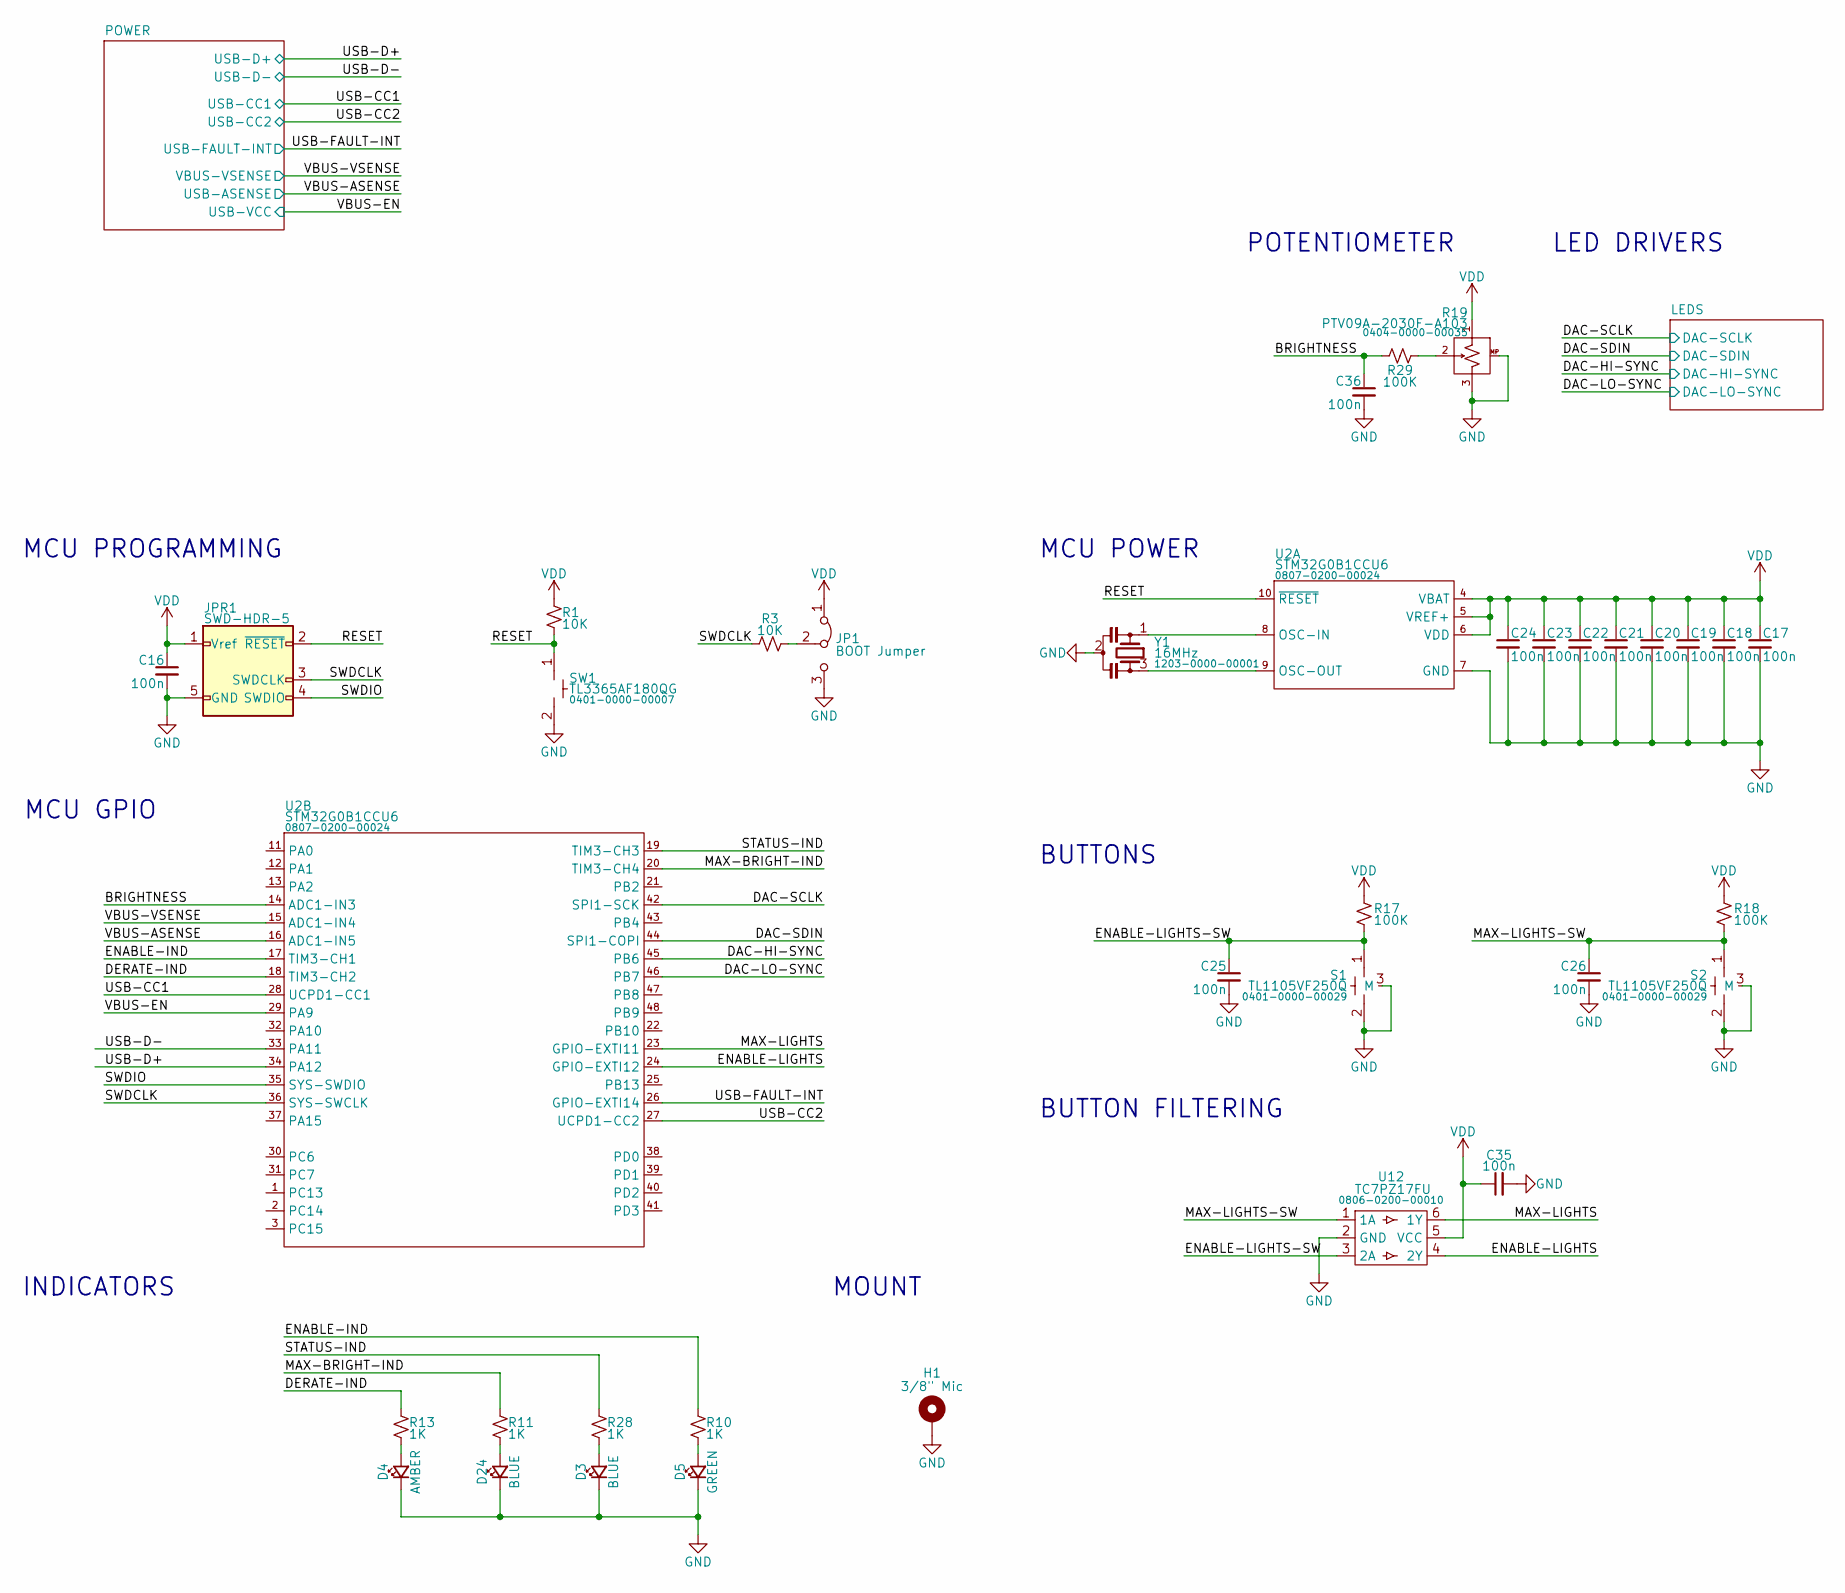
[picture p11: schematic MicLightV2.kicad_sch, MicLight Version 2 - Main]

Parts:
C16, C17, C18, C19, C20, C21, C22, C23, C24, C25, C26, C35, C36: 100n; CAP_0402; PartNumber 0201-0100-00001
D3, D24: LTST-S321TBKT; PartNumber 0902-0000-00004
D4: IN-S63AS5UW; LTST-S321TBKT; PartNumber 0902-0000-00002
D5: SM1204SGC; LTST-S321TBKT; PartNumber 0902-0000-00005
H1: 3/8" Mic; MountingHole_0.375in_Mic_Stand
JP1: BOOT Jumper; SolderJumper-3_P1.3mm_Open_RoundedPad1.0x1.5mm
JPR1: SWD-HDR-5; PinHeader_1x05_P2.54mm_Vertical
R1, R3: 10K; RES_0402; PartNumber 0204-0000-00016
R10, R11, R13, R28: 1K; RES_0402; PartNumber 0204-0000-00032
R17, R18, R29: 100K; RES_0402; PartNumber 0204-0000-00013
R19: PTV09A-2030F-A103; PartNumber 0404-0000-00035
S1, S2: TL1105VF250Q; TL1105VF; PartNumber 0401-0000-00029
SW1: TL3365AF180QG; PartNumber 0401-0000-00007
U2: STM32G0B1CCU6; QFN-48-1EP_7x7mm_P0.5mm_EP5.6x5.6mm; PartNumber 0807-0200-00024
U12: TC7PZ17FU; SOT-363_SC-70-6; PartNumber 0806-0200-00010
Y1: 16MHz; Resonator_SMD_3Pin_3.0x1.1mm; PartNumber 1203-0000-00001

Connections:
/BRIGHTNESS: C36.1, R29.1, U2.14 (PA3)
/DAC-HI-SYNC: U2.45 (PB6); also elsewhere on the board
/DAC-LO-SYNC: U2.46 (PB7); also elsewhere on the board
/DAC-SCLK: U2.42 (SPI1-SCK); also elsewhere on the board
/DAC-SDIN: U2.44 (SPI1-COPI); also elsewhere on the board
/DERATE-IND: R13.1, U2.18 (TIM3-CH2)
/ENABLE-IND: R10.1, U2.17 (TIM3-CH1)
/ENABLE-LIGHTS: U2.24 (GPIO-EXTI12), U12.4 (2Y)
/ENABLE-LIGHTS-SW: C25.1, R17.2, S1.1, U12.3 (2A)
/MAX-BRIGHT-IND: R11.1, U2.20 (TIM3-CH4)
/MAX-LIGHTS: U2.23 (GPIO-EXTI11), U12.6 (1Y)
/MAX-LIGHTS-SW: C26.1, R18.2, S2.1, U12.1 (1A)
/RESET: JPR1.2 (~RESET), R1.2, SW1.1, U2.10 (~RESET)
/STATUS-IND: R28.1, U2.19 (TIM3-CH3)
/SWDCLK: JPR1.3 (SWDCLK), R3.1, U2.36 (SYS-SWCLK)
/SWDIO: JPR1.4 (SWDIO), U2.35 (SYS-SWDIO)
/USB-CC1: U2.28 (UCPD1-CC1); also elsewhere on the board
/USB-CC2: U2.27 (UCPD1-CC2); also elsewhere on the board
/USB-D+: U2.34 (PA12); also elsewhere on the board
/USB-D-: U2.33 (PA11); also elsewhere on the board
/USB-FAULT-INT: U2.26 (GPIO-EXTI14); also elsewhere on the board
/VBUS-ASENSE: U2.16 (PA5); also elsewhere on the board
/VBUS-VSENSE: U2.15 (PA4); also elsewhere on the board
GND: C16.2, C17.2, C18.2, C19.2, C20.2, C21.2, C22.2, C23.2, C24.2, C25.2, C26.2, C35.2, C36.2, D3.1 (K), D4.1 (K), D5.1 (K), D24.1 (K), H1.1, JP1.3 (B), JPR1.5 (GND), R19.3 (B), R19.MP (Mount), S1.2, S1.3 (M), S2.2, S2.3 (M), SW1.2, U2.7 (GND), U2.49 (GND), U12.2 (GND), Y1.2; also elsewhere on the board
unnamed: D3.2 (A), R28.2
unnamed: D4.2 (A), R13.2
unnamed: D5.2 (A), R10.2
unnamed: D24.2 (A), R11.2
unnamed: JP1.2 (C), R3.2
unnamed: R19.2 (W), R29.2
unnamed: U2.8 (OSC-IN), Y1.1
unnamed: U2.9 (OSC-OUT), Y1.3
VDD: C16.1, C17.1, C18.1, C19.1, C20.1, C21.1, C22.1, C23.1, C24.1, C35.1, JP1.1 (A), JPR1.1 (Vref), R1.1, R17.1, R18.1, R19.1 (A), U2.4 (VBAT), U2.5 (VREF+), U2.6 (VDD), U12.5 (VCC); also elsewhere on the board

Notes on the sheet:
MCU GPIO
BUTTON FILTERING
INDICATORS
LED DRIVERS
POTENTIOMETER
MCU POWER
MCU PROGRAMMING
MOUNT
BUTTONS

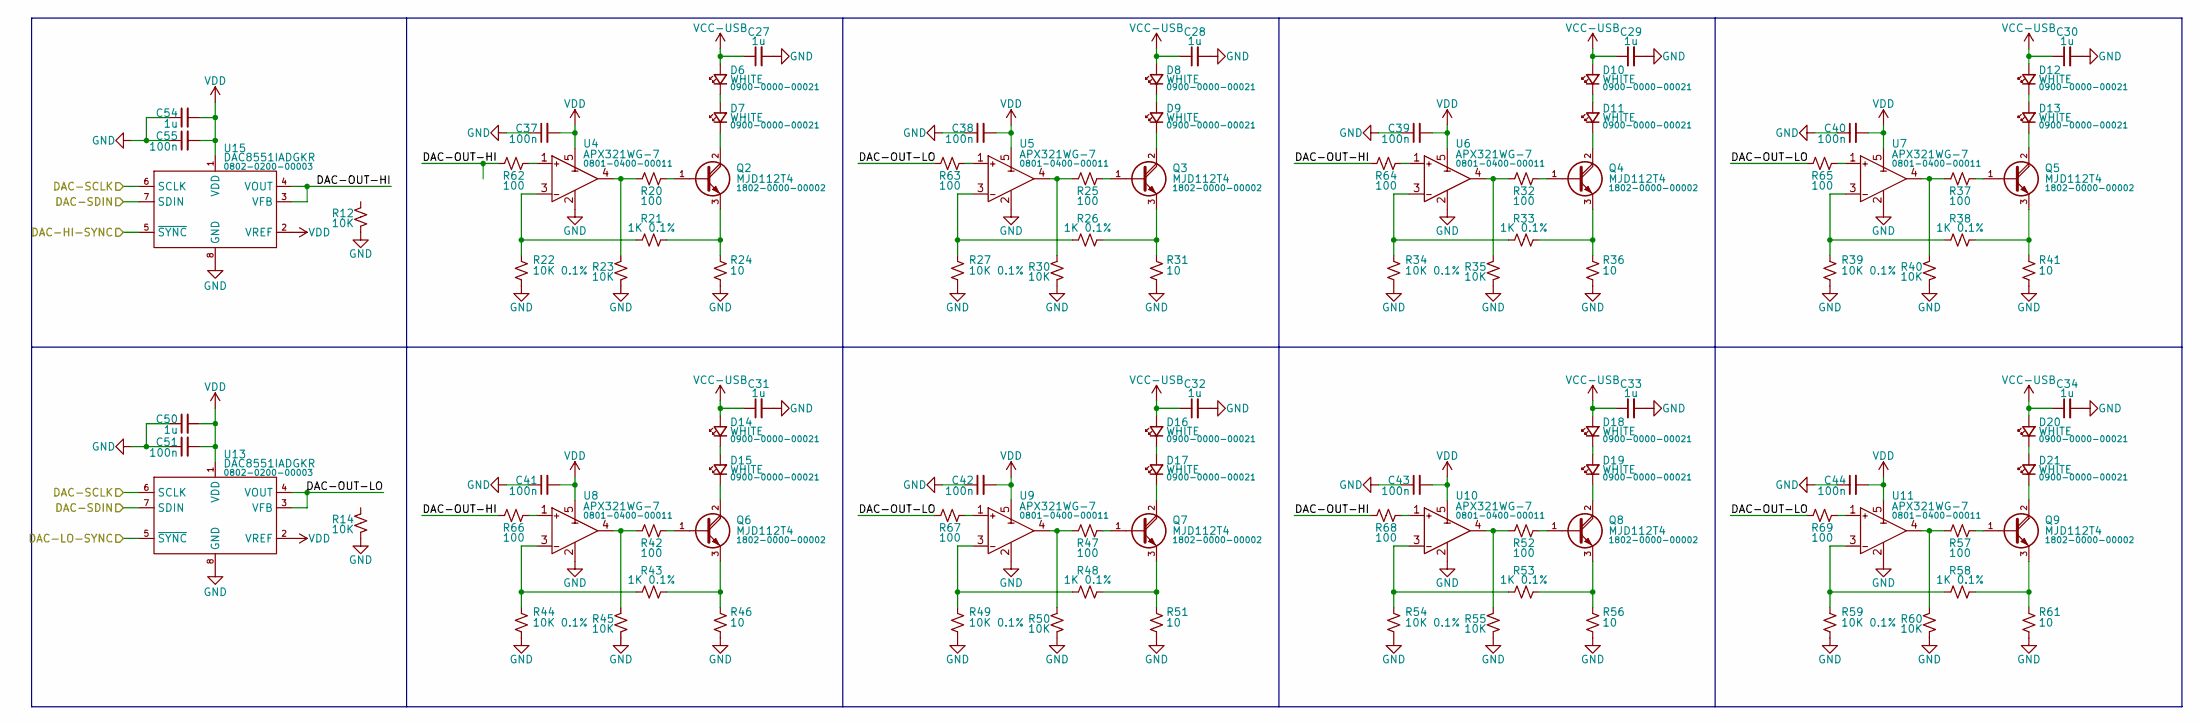
[picture p12: schematic MicLightV2-LEDs.kicad_sch, MicLight Version 2 - LEDs]

Parts:
C27, C28, C29, C30, C31, C32, C33, C34: 1u; CAP_0603; PartNumber 0201-0100-00051
C37, C38, C39, C40, C41, C42, C43, C44, C51, C55: 100n; CAP_0402; PartNumber 0201-0100-00001
C50, C54: 1u; CAP_0402; PartNumber 0201-0100-00050
D6, D7, D8, D9, D10, D11, D12, D13, D14, D15, D16, D17, D18, D19, D20, D21: JK3030AWT-P-H40EA0000-N0000001; JK3030AWT; PartNumber 0900-0000-00021
Q2, Q3, Q4, Q5, Q6, Q7, Q8, Q9: MJD112T4; TO-252-2; PartNumber 1802-0000-00002
R12, R14, R23, R30, R35, R40, R45, R50, R55, R60: 10K; RES_0402; PartNumber 0204-0000-00016
R20, R25, R32, R37, R42, R47, R52, R57: 100; RES_0402
R21, R26, R33, R38, R43, R48, R53, R58: 1K 0.1%; RES_0402; PartNumber 0204-0100-00012
R22, R27, R34, R39, R44, R49, R54, R59: 10K 0.1%; RES_0402; PartNumber 0204-0100-00019
R24, R31, R36, R41, R46, R51, R56, R61: 10; RES_1218; PartNumber 0204-0200-00031
R62, R63, R64, R65, R66, R67, R68, R69: 100; RES_0402; PartNumber 0204-0000-00011
U4, U5, U6, U7, U8, U9, U10, U11: APX321WG-7; SOT-23-5; PartNumber 0801-0400-00011
U13, U15: DAC8551IADGKR; VSSOP-8_3.0x3.0mm_P0.65mm; PartNumber 0802-0200-00003

Connections:
/DAC-HI-SYNC: U15.5 (~SYNC); also elsewhere on the board
/DAC-LO-SYNC: U13.5 (~SYNC); also elsewhere on the board
/DAC-SCLK: U13.6 (SCLK), U15.6 (SCLK); also elsewhere on the board
/DAC-SDIN: U13.7 (SDIN), U15.7 (SDIN); also elsewhere on the board
/LEDS/DAC-OUT-HI: R62.1, R64.1, R66.1, R68.1, U15.3 (VFB), U15.4 (VOUT)
/LEDS/DAC-OUT-LO: R63.1, R65.1, R67.1, R69.1, U13.3 (VFB), U13.4 (VOUT)
GND: C27.2, C28.2, C29.2, C30.2, C31.2, C32.2, C33.2, C34.2, C37.1, C38.1, C39.1, C40.1, C41.1, C42.1, C43.1, C44.1, C50.1, C51.1, C54.1, C55.1, R12.2, R14.2, R22.2, R23.2, R24.2, R27.2, R30.2, R31.2, R34.2, R35.2, R36.2, R39.2, R40.2, R41.2, R44.2, R45.2, R46.2, R49.2, R50.2, R51.2, R54.2, R55.2, R56.2, R59.2, R60.2, R61.2, U4.2 (V-), U5.2 (V-), U6.2 (V-), U7.2 (V-), U8.2 (V-), U9.2 (V-), U10.2 (V-), U11.2 (V-), U13.8 (GND), U15.8 (GND); also elsewhere on the board
unnamed: D6.1 (K), D7.2 (A)
unnamed: D7.1 (K), Q2.2 (C)
unnamed: D8.1 (K), D9.2 (A)
unnamed: D9.1 (K), Q3.2 (C)
unnamed: D10.1 (K), D11.2 (A)
unnamed: D11.1 (K), Q4.2 (C)
unnamed: D12.1 (K), D13.2 (A)
unnamed: D13.1 (K), Q5.2 (C)
unnamed: D14.1 (K), D15.2 (A)
unnamed: D15.1 (K), Q6.2 (C)
unnamed: D16.1 (K), D17.2 (A)
unnamed: D17.1 (K), Q7.2 (C)
unnamed: D18.1 (K), D19.2 (A)
unnamed: D19.1 (K), Q8.2 (C)
unnamed: D20.1 (K), D21.2 (A)
unnamed: D21.1 (K), Q9.2 (C)
unnamed: Q2.1 (B), R20.2
unnamed: Q2.3 (E), R21.2, R24.1
unnamed: Q3.1 (B), R25.2
unnamed: Q3.3 (E), R26.2, R31.1
unnamed: Q4.1 (B), R32.2
unnamed: Q4.3 (E), R33.2, R36.1
unnamed: Q5.1 (B), R37.2
unnamed: Q5.3 (E), R38.2, R41.1
unnamed: Q6.1 (B), R42.2
unnamed: Q6.3 (E), R43.2, R46.1
unnamed: Q7.1 (B), R47.2
unnamed: Q7.3 (E), R48.2, R51.1
unnamed: Q8.1 (B), R52.2
unnamed: Q8.3 (E), R53.2, R56.1
unnamed: Q9.1 (B), R57.2
unnamed: Q9.3 (E), R58.2, R61.1
unnamed: R62.2, U4.1 (IN+)
unnamed: R21.1, R22.1, U4.3 (IN-)
unnamed: R20.1, R23.1, U4.4 (OUT)
unnamed: R63.2, U5.1 (IN+)
unnamed: R26.1, R27.1, U5.3 (IN-)
unnamed: R25.1, R30.1, U5.4 (OUT)
unnamed: R64.2, U6.1 (IN+)
unnamed: R33.1, R34.1, U6.3 (IN-)
unnamed: R32.1, R35.1, U6.4 (OUT)
unnamed: R65.2, U7.1 (IN+)
unnamed: R38.1, R39.1, U7.3 (IN-)
unnamed: R37.1, R40.1, U7.4 (OUT)
unnamed: R66.2, U8.1 (IN+)
unnamed: R43.1, R44.1, U8.3 (IN-)
unnamed: R42.1, R45.1, U8.4 (OUT)
unnamed: R67.2, U9.1 (IN+)
unnamed: R48.1, R49.1, U9.3 (IN-)
unnamed: R47.1, R50.1, U9.4 (OUT)
unnamed: R68.2, U10.1 (IN+)
unnamed: R53.1, R54.1, U10.3 (IN-)
unnamed: R52.1, R55.1, U10.4 (OUT)
unnamed: R69.2, U11.1 (IN+)
unnamed: R58.1, R59.1, U11.3 (IN-)
unnamed: R57.1, R60.1, U11.4 (OUT)
VCC-USB: C27.1, C28.1, C29.1, C30.1, C31.1, C32.1, C33.1, C34.1, D6.2 (A), D8.2 (A), D10.2 (A), D12.2 (A), D14.2 (A), D16.2 (A), D18.2 (A), D20.2 (A); also elsewhere on the board
VDD: C37.2, C38.2, C39.2, C40.2, C41.2, C42.2, C43.2, C44.2, C50.2, C51.2, C54.2, C55.2, U4.5 (V+), U5.5 (V+), U6.5 (V+), U7.5 (V+), U8.5 (V+), U9.5 (V+), U10.5 (V+), U11.5 (V+), U13.1 (VDD), U13.2 (VREF), U15.1 (VDD), U15.2 (VREF); also elsewhere on the board

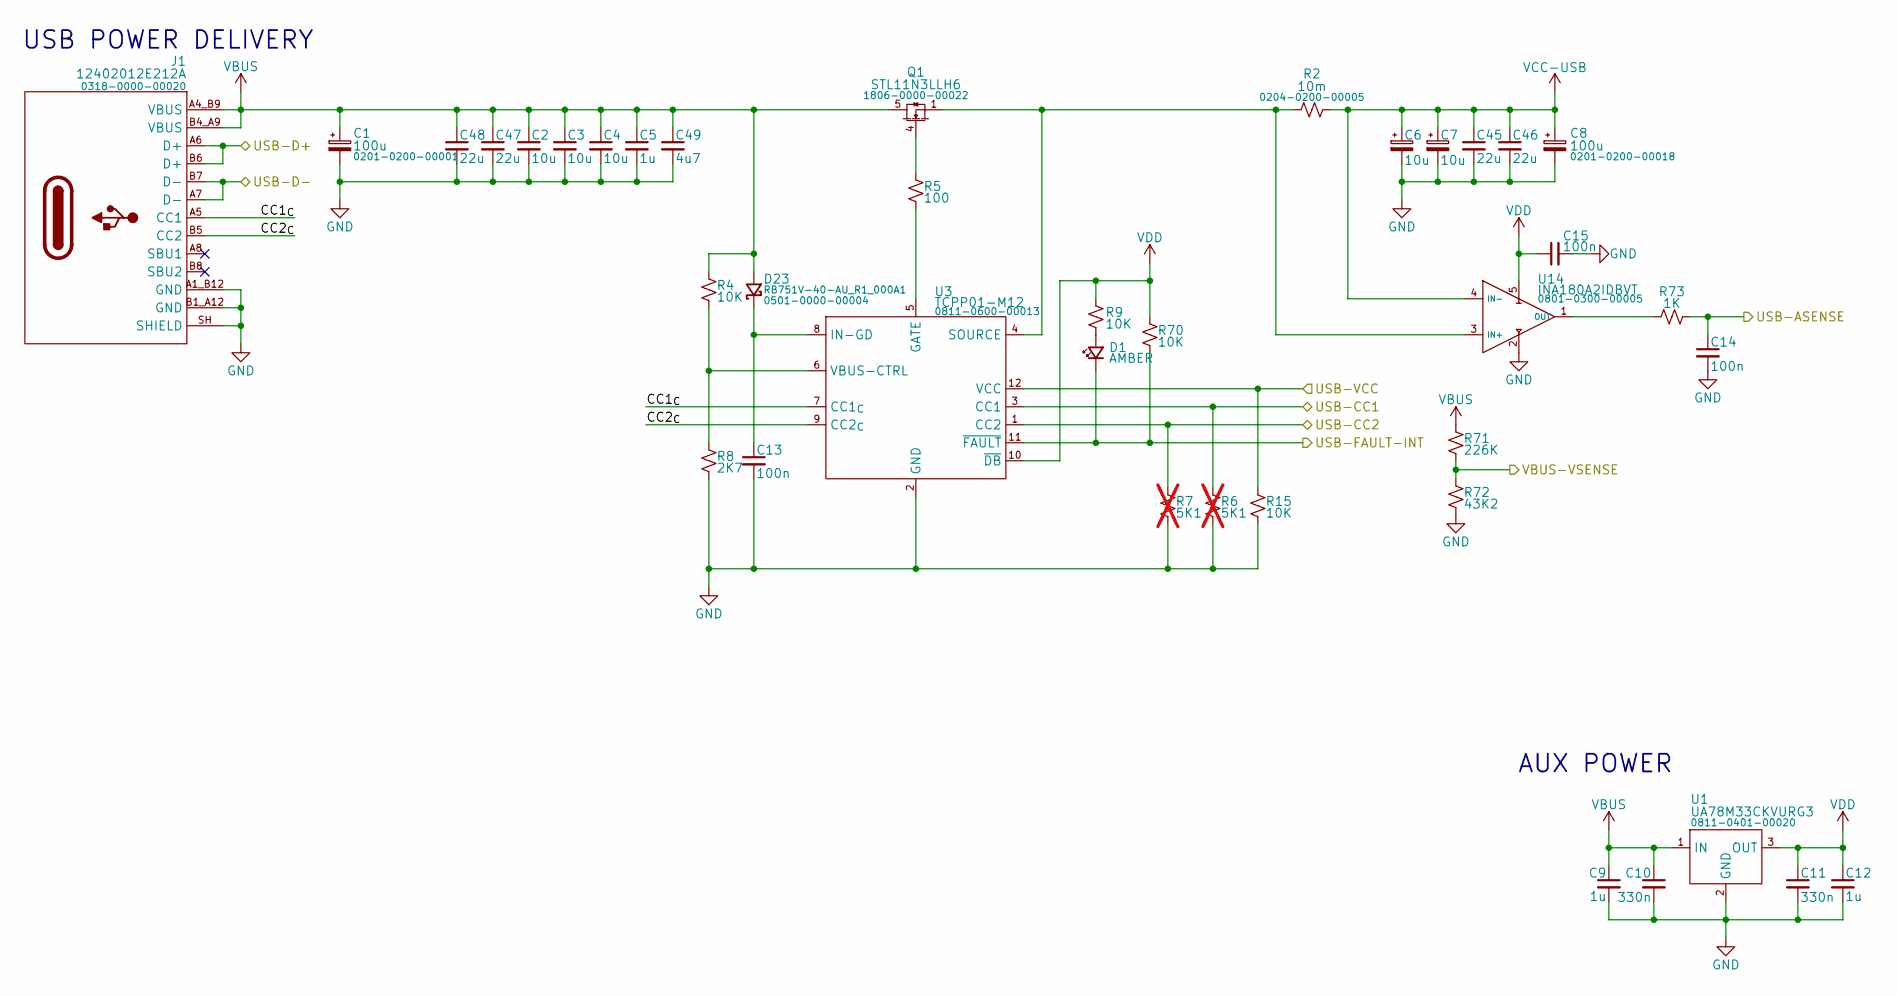
[picture p13: schematic MicLightV2_Power.kicad_sch, MicLight Version 2 - Power]

Parts:
C1: 100u; CAP_EL_8x10; PartNumber 0201-0200-00001
C2, C3, C4: 10u; CAP_1210; PartNumber 0201-0100-00040
C5, C9, C12: 1u; CAP_0603; PartNumber 0201-0100-00051
C6, C7: 10u; C-TANT-1210_EIA-3528; PartNumber 0201-0300-00008
C8: 100u; CAP_EL_6.3x7.7; PartNumber 0201-0200-00018
C10, C11: 330n; CAP_0402
C13, C15: 100n; CAP_0402; PartNumber 0201-0100-00001
C14: 100n; CAP_0402
C45, C46, C47, C48: 22u; CAP_1206; PartNumber 0201-0100-00067
C49: 4u7; CAP_0805; PartNumber 0201-0100-00074
D1: IN-S63AS5UW; LTST-S321TBKT; PartNumber 0902-0000-00002
D23: RB751V-40-AU_R1_000A1; D_SOD-323; PartNumber 0501-0000-00004
J1: 12402012E212A; PartNumber 0318-0000-00020
Q1: STL11N3LLH6; POWERFLAT_3.3MM; PartNumber 1806-0000-00022
R2: 10m; RES_1206; PartNumber 0204-0200-00005
R4, R9, R15, R70: 10K; RES_0402; PartNumber 0204-0000-00016
R5: 100; RES_0402; PartNumber 0204-0000-00011
R6, R7: 5K1; RES_0402; PartNumber 0204-0000-00115; not fitted
R8: 2K7; RES_0402; PartNumber 0204-0000-00121
R71: 226K; RES_0402; PartNumber 0204-0000-00048
R72: 43K2; RES_0402; PartNumber 0204-0000-00110
R73: 1K; RES_0402
U1: UA78M33CKVURG3; TO-252-2; PartNumber 0811-0401-00020
U3: TCPP01-M12; QFN-12-1EP_3x3mm_P0.5mm_EP1.45x1.45mm; PartNumber 0811-0600-00013
U14: INA180A2IDBVT; SOT-23-5; PartNumber 0801-0300-00005

Connections:
/POWER/CC1_{C}: J1.A5 (CC1), U3.7 (CC1_{C})
/POWER/CC2_{C}: J1.B5 (CC2), U3.9 (CC2_{C})
/USB-CC1: R6.1, U3.3 (CC1); also elsewhere on the board
/USB-CC2: R7.1, U3.1 (CC2); also elsewhere on the board
/USB-D+: J1.A6 (D+), J1.B6 (D+); also elsewhere on the board
/USB-D-: J1.A7 (D-), J1.B7 (D-); also elsewhere on the board
/USB-FAULT-INT: D1.1 (K), R70.2, U3.11 (~FAULT); also elsewhere on the board
/VBUS-ASENSE: C14.1, R73.2; also elsewhere on the board
/VBUS-VSENSE: R71.2, R72.1; also elsewhere on the board
GND: C1.2 (-), C2.2, C3.2, C4.2, C5.2, C6.2, C7.2, C8.2 (-), C9.2, C10.2, C11.2, C12.2, C13.2, C14.2, C15.2, C45.2, C46.2, C47.2, C48.2, C49.2, J1.A1_B12 (GND), J1.B1_A12 (GND), J1.SH (SHIELD), R6.2, R7.2, R8.2, R15.2, R72.2, U1.2 (GND), U3.2 (GND), U3.13 (GND), U14.2 (GND); also elsewhere on the board
unnamed: D1.2 (A), R9.2
unnamed: C13.1, D23.1 (K), U3.8 (IN-GD)
unnamed: Q1.4 (G), R5.1
unnamed: R5.2, U3.5 (GATE)
unnamed: R4.2, R8.1, U3.6 (VBUS-CTRL)
unnamed: R73.1, U14.1 (OUT)
S: Q1.1 (S), Q1.2 (S), Q1.3 (S), R2.1, U3.4 (SOURCE), U14.3 (IN+)
VBUS: C1.1 (+), C2.1, C3.1, C4.1, C5.1, C9.1, C10.1, C47.1, C48.1, C49.1, D23.2 (A), J1.A4_B9 (VBUS), J1.B4_A9 (VBUS), Q1.5 (D), R4.1, R71.1, U1.1 (IN)
VCC-USB: C6.1, C7.1, C8.1 (+), C45.1, C46.1, R2.2, U14.4 (IN-); also elsewhere on the board
VDD: C11.1, C12.1, C15.1, R9.1, R15.1, R70.1, U1.3 (OUT), U3.10 (~DB), U3.12 (VCC), U14.5 (VS); also elsewhere on the board

Notes on the sheet:
USB POWER DELIVERY
AUX POWER

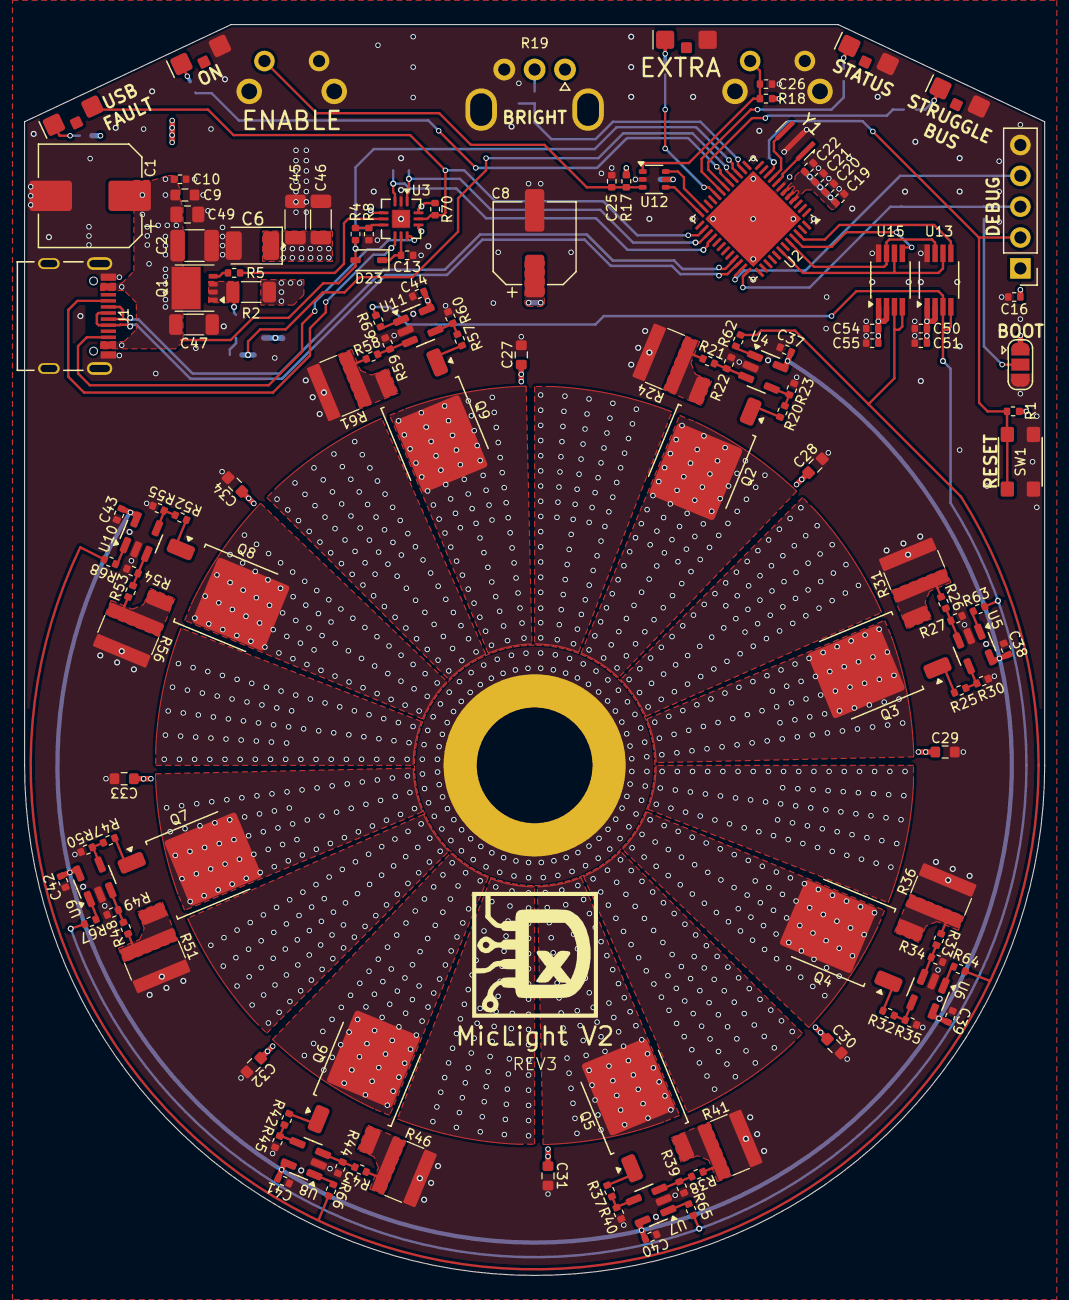
[picture p14: board MicLightV2.kicad_pcb from above]

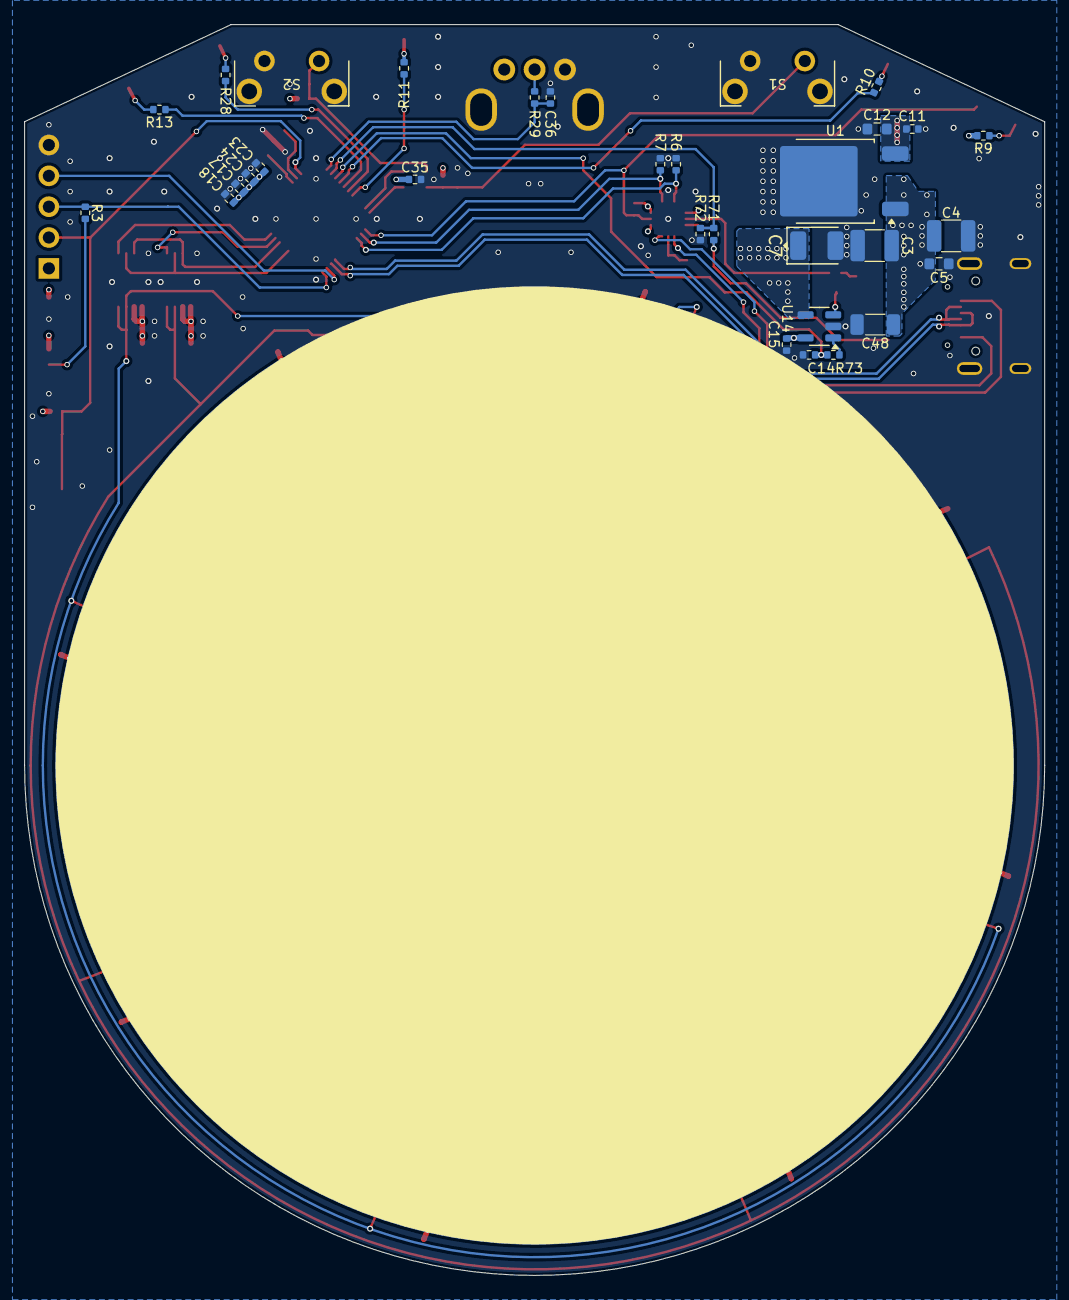
[picture p15: board MicLightV2.kicad_pcb from below]

Board: 4 copper layers, 84.0 x 103.0 mm, 176 parts (47 on the bottom side), 102 nets.
