Daxxn/MicLightV2_PCB/(commit log)

2025-03-22 Finish REV1 - Sent to board house.
    [MicLightV2-LEDs.kicad_sch, MicLightV2.kicad_pcb, MicLightV2.kicad_sch, MicLightV2_REV1.csv]
2025-03-22 Remove KiCad lock file
2025-09-01 REV2 - add DAC and cc led drivers
    [MicLightV2-LEDs.kicad_sch, MicLightV2.kicad_pcb, MicLightV2.kicad_sch, MicLightV2_REV2.csv]
2026-08-29 Replace led drive fets and usb-pd system
2026-09-27 WIP - Fix incorrect wiring
